Global-Health-Labs/NAATOS/readme.md

# NAATOS Documentation Website

Please visit <https://global-health-labs.github.io/NAATOS/> to learn about NAATOS and how to use this repository.
