Global-Health-Labs/NAATOS/docs/team.md

# Project Team

## Global Health Labs (GHL)

GHL is the lead developer of NAATOS, having invested in several areas of early stage research related to new tools and technologies for diagnosis of tuberculosis (and other endemic infectious diseases) in low-resource settings.

### Research and Development

- Luis Alonzo [:material-linkedin:](https://www.linkedin.com/in/luisalonzo/){:target="_blank"}
- Lex Ball [:material-linkedin:](https://www.linkedin.com/in/lex-ball-a0041219/){:target="_blank"}
- [Josh Bishop](https://github.com/jdbishop) [:material-linkedin:](https://www.linkedin.com/in/josh-bishop-ph-d-6207324/){:target="_blank"}
- Rose Buchmann [:material-linkedin:](https://www.linkedin.com/in/rosebuchmann/){:target="_blank"}
- [Stephen Burkot](https://github.com/sburkot24) [:material-linkedin:](https://www.linkedin.com/in/stephenburkot/){:target="_blank"}
- [Ryan Calderon](https://github.com/rcalderon04) [:material-linkedin:](https://www.linkedin.com/in/ryan-calderon-a6a02625/){:target="_blank"}
- Jason Cantera [:material-linkedin:](https://www.linkedin.com/in/jason-cantera-87554319/){:target="_blank"}
- John Connelly [:material-linkedin:](https://www.linkedin.com/in/john-connelly-22849122/){:target="_blank"}
- [Mike Deeds](https://deedstech.com/)
- Ming Dong [:material-linkedin:](https://www.linkedin.com/in/ming-dong-mba/){:target="_blank"}
- Ryan Gallagher [:material-linkedin:](https://www.linkedin.com/in/ryan-gallagher-308a41227/){:target="_blank"}
- Spencer Garing [:material-linkedin:](https://www.linkedin.com/in/spencer-garing-40a57796/){:target="_blank"}
- [Simon Ghionea](https://github.com/sghionea) [:material-linkedin:](https://www.linkedin.com/in/simonghionea/){:target="_blank"}
- Ben Grant [:material-linkedin:](https://www.linkedin.com/in/benjamin-grant-4a9a4222/){:target="_blank"}
- [Chin Ng Hei](https://github.com/ngchei) [:material-linkedin:](https://www.linkedin.com/in/chin-ng-ph-d-21522013/){:target="_blank"}
- Lance Jacobe [:material-linkedin:](https://www.linkedin.com/in/lancejacobemicro/){:target="_blank"}
- Jordyn Janshen [:material-linkedin:](https://www.linkedin.com/in/jordyn-janshen-/){:target="_blank"}
- [Matt Keller](https://github.com/mkeller99) [:material-linkedin:](https://www.linkedin.com/in/matt-keller-a360b483/){:target="_blank"}
- Khushboo Khimani [:material-linkedin:](https://www.linkedin.com/in/khushboo-khimani/){:target="_blank"}
- Remy Kooistra [:material-linkedin:](https://www.linkedin.com/in/remy-kooistra-0970a5114/){:target="_blank"}
- Anne-Laure Le Ny [:material-linkedin:](https://www.linkedin.com/in/anne-laure-le-ny-a7377a3/){:target="_blank"}
- [Andrew Miller](https://github.com/andrewmiller-ghl) [:material-linkedin:](https://www.linkedin.com/in/andrew-miller-78938520/){:target="_blank"}
- Eric Nalefski [:material-linkedin:](https://www.linkedin.com/in/eric-nalefski-0b942714/){:target="_blank"}
- Bryan Norton [:material-linkedin:](https://www.linkedin.com/in/bryanjnorton/){:target="_blank"}
- Julie Pendergraft [:material-linkedin:](https://www.linkedin.com/in/julielpendergraft/){:target="_blank"}
- Jamie Purcell [:material-linkedin:](https://www.linkedin.com/in/jamie-purcell-phd-098aa65a/){:target="_blank"}
- Rafael Rivera [:material-linkedin:](https://www.linkedin.com/in/rafael-rivera-437553124/){:target="_blank"}
- Anjali Sehrawat [:material-linkedin:](https://www.linkedin.com/in/anjalisehrawat/){:target="_blank"}
- Ethan Spencer [:material-linkedin:](https://www.linkedin.com/in/ethanrspencer/){:target="_blank"}
- Amy Steadman [:material-linkedin:](https://www.linkedin.com/in/amy-steadman-aa80578b/){:target="_blank"}
- Ben Sullivan [:material-linkedin:](https://www.linkedin.com/in/benpsullivan/){:target="_blank"}
- Wenbo Wang [:material-linkedin:](https://www.linkedin.com/in/wenbowang1pe/){:target="_blank"}
- Xiaohong Zhang [:material-linkedin:](https://www.linkedin.com/in/xiaohong-zhang22111/){:target="_blank"}

### Product Management

- Isabel Izek [:material-linkedin:](https://www.linkedin.com/in/isabel-izek/){:target="_blank"}

### Program Management

- Nikki Sanchez Comeau [:material-linkedin:](https://www.linkedin.com/in/nikkisanchezcomeau/){:target="_blank"}

### Clinical

- Julian Atim [:material-linkedin:](https://www.linkedin.com/in/jatim/){:target="_blank"}
- Christine Bachman [:material-linkedin:](https://www.linkedin.com/in/cmbachman/){:target="_blank"}

### Legal

- Davina Inslee [:material-linkedin:](https://www.linkedin.com/in/davina-childs-inslee-0268a93/){:target="_blank"}
- Kris Weafer [:material-linkedin:](https://www.linkedin.com/in/kristiest/){:target="_blank"}

### Quality

- Stacy Hyatt [:material-linkedin:](https://www.linkedin.com/in/stacy-hyatt/){:target="_blank"}
- Cheryl Taylor [:material-linkedin:](https://www.linkedin.com/in/cheryl-taylor-880a48/){:target="_blank"}

### Program Strategy

- Sharon Bergquist [:material-linkedin:](https://www.linkedin.com/in/sharonbergquist/){:target="_blank"}
- Carlos Gonzalez [:material-linkedin:](https://www.linkedin.com/in/cbgonz%C3%A1lezphd/){:target="_blank"}
- Rob Jenison [:material-linkedin:](https://www.linkedin.com/in/rob-jenison-9540018/){:target="_blank"}
- Steve Kern [:material-linkedin:](https://www.linkedin.com/in/se-kern/){:target="_blank"}
- Bernhard Weigl [:material-linkedin:](https://www.linkedin.com/in/bernhard-h-weigl/){:target="_blank"}

## Collaborators

### ACT-IVD

ACT-IVD is the Regulatory consultant for NAATOS.

- Robyn Meurant [:material-linkedin:](https://www.linkedin.com/in/robyn-meurant-act-ivd/){:target="_blank"}

### [Central Centerless Grinding (CCG)](http://ccgonline.net/){:target="_blank"} / [Scitus Engineering](http://scitusengineering.com/){:target="_blank"}

[CCG](http://ccgonline.net/){:target="_blank"} is the Hardware Design and Instrument Manufacturing partner for the NAATOS TB V1 modules.

- Philip Almquist
- Mark Flanagan[^CCG]
- James Paolino[^CCG]
- Ed Sienczylo
- David Sorenson
- Binh Tran

### [Diagnostics Consulting Network (DCN)](https://dcndx.com/){:target="_blank"}

[DCN Dx](https://dcndx.com/){:target="_blank"} is the Development, Kit Production, and Technology Transfer partner for NAATOS.

### [Global Access Diagnostics (GADx)](https://www.globalaccessdx.com/){:target="_blank"}

[GADx](https://www.globalaccessdx.com/){:target="_blank"} is the Research and Development partner for NAATOS.

- Lucy Beales
- Mike Best
- Sarah Chapman
- Paul Davis
- Michael Johnson
- Gabriela Kocurova
- Kevin Land[^GADx]
- Gerhard Nebe-Von-Caron
- Katherine Rumary
- Peter Salkield
- Adrian Walker
- Xiaoxiang (Tom) Yan

### [Greaves Best Design](http://www.greavesbest.co.uk/){:target="_blank}

- Mike Best is the Product Design partner for NAATOS TB V1.

### [Health Innovation Advisors (HIA)](https://innovationadvisors.org/){:target="_blank"}

[HIA](https://innovationadvisors.org/){:target="_blank"} is the User Research and Implementation Science consultant for NAATOS.

- Melissa Mugambi[^HIA] [:material-linkedin:](https://www.linkedin.com/in/melissamugambi/){:target="_blank"}

### [Market Access Africa (MAA)](https://www.marketaccess.africa/){:target="_blank"}

[MAA](https://www.marketaccess.africa/){:target="_blank"} is the Market Research and Product Introduction consultant for NAATOS.

- Olawale Ajose[^MAA] [:material-linkedin:](https://www.linkedin.com/in/olawale-ajose-1521b975/){:target="_blank"}
- Obakeng Bagopi
- Zipporah Bundi
- Nancy Njoku-Attah
- Wambui Nyabero
- Pam Pillay[^MAA] [:material-linkedin:](https://www.linkedin.com/in/pam-pillay-a7b5ba65/){:target="_blank"}
- Newton Runyowa
- Chris Smit
- Shabnam Zavahir

### [MicroMed Solutions](https://www.micromedsolutions.com/){:target="_blank"}, a division of LasX Industries

[MicroMed Solutions](https://www.micromedsolutions.com/){:target="_blank"} is the Converting vendor for NAATOS.

- Jon Craven[^MicroMed]
- Rye Mecum
- Derek Spencer
- Hanh Tran

### [Odic](https://odic.com/){:target="_blank"}

[Odic](https://odic.com/){:target="_blank"} is the Electronics Design partner for the NAATOS TB V1 modules.

- Rob Filipkowski[^Odic]
- Liam Sullivan
- Ian O’Neil
- Dylan Derose

### [Vantage MedTech](https://vantagemedtech.com/){:target="_blank"}

[Vantage](https://vantagemedtech.com/){:target="_blank"} is the Industrial Design vendor for NAATOS V2.

- Steven Madsen
- Thomas Van Dyk

[^CCG]: Corresponding team members for CCG.
[^GADx]: Corresponding team member for GADx.
[^HIA]: Corresponding team member for HIA.
[^MAA]: Corresponding team members for MAA.
[^MicroMed]: Corresponding team member for MicroMed Solutions.
[^Odic]: Corresponding team member for Odic.
