Global-Health-Labs/NAATOS/docs/index.md

# NAATOS Project Overview

## The Diagnostics Gap in Primary Health Care

Health systems based on primary health care (PHC) have better population health, health equity, health care quality, and lower health expenditure.[^1] However, access to accurate and affordable diagnostics remains the weakest link in primary care worldwide.[^2] Without accurate and timely diagnosis many people with treatable diseases (e.g., TB, HIV/AIDS, malaria, pneumonia, hepatitis C, etc.) go undetected, impacting health and economic outcomes for much of the world's population.

Low- and middle-income countries (LMICs) in particular need scalable and regionally produced diagnostic solutions to ensure inclusive and equitable responses to global health threats and local health needs. International resolutions, like the World Health Assembly Resolution 76.5,[^3] and initiatives, like the Africa Collaborative Initiative to Advance Diagnostics (AFCAD),[^4] aim to strengthen diagnostic capacity, promote local manufacturing, and harmonize regulatory processes, particularly in low-income countries[^5]. But to realize these targets globally, a sustainable and resilient ecosystem of regional research and product development must exist in LMICs to ensure health priorities are met locally.[^6] This approach is essential to build resilience in healthcare systems and to foster a responsive and self-sufficient local industry capable of addressing global health threats.

[Global Health Labs (GHL)](https://gatesopenresearch.org/gateways/ghlabs/about-this-gateway){:target="_blank"} was a non-profit organization that from 2020 to 2025 created and de-risked innovative health technologies with the ultimate goal of enabling manufacturing and commercialization partners to make them available at the point of need. One product of GHL is NAATOS, Nucleic Acid Amplification Test On a Strip. NAATOS is a novel diagnostic platform conceived at GHL that integrates Nucleic Acid Amplification Test (NAAT) and Lateral Flow Assay (LFA) technologies to empower primary health care and diagnostic ecosystems with tests that are sensitive, specific, affordable, easy-to-use, and available.

NAATs are the gold standard for sensitivity and specificity in diagnostics, but their success depends on expensive lab infrastructure (e.g., reliable power, environmental controls, equipment maintenance) that is cost-prohibitive for PHC settings, most of which have only basic lab capabilities. LFAs bridge this gap by offering a low-cost and easy-to-use alternative that can be locally produced and readily deployed at the point of care in PHC, but LFAs lack the sensitivity and specificity of NAATs. NAATOS is a blueprint for obtaining the best characteristics of these technologies without their drawbacks.

## [NAATOS TB V1](./TB-V1/overview.md)

The United Nations Sustainable Development Goal 3.3 targets an end to the global tuberculosis epidemic by 2030.[^7] Unfortunately, poor diagnostic access and low utilization of TB testing has allowed large-scale treatment delays and disease transmission. However, these issues can be addressed with an accurate, affordable, and accessible diagnostic tool that meets the performance criteria of high sensitivity, specificity (95% specificity), and affordability ($4.5 USD all-inclusive) set out by the WHO.[^8]

The first demonstrated application of NAATOS is as an aid in diagnosis for tuberculosis (TB) in individuals 15 years of age and older with signs and symptoms of pulmonary TB. This version of NAATOS, TB V1, is a modular, instrumented-but-portable diagnostic system that returns genetic confirmation of *Mycobacterium tuberculosis* in a dorsal tongue swab specimen and accommodates variable patient volumes in near-point-of-care settings.

## [NAATOS V2](./V2/overview.md)

The next generation of NAATOS is a fully disposable, non-instrumented diagnostic platform. This version of NAATOS, V2, combines the core consumable technology of NAATOS TB V1 with a disposable power and control component that replaces the modular instrumentation of NAATOS TB V1. NAATOS V2 is intended as a blueprint for tests without difficult sample preparation requirements in true point-of-care settings. As an example, the design for a multiplexed HPV test is provided.

## The Future of NAATOS

The goal of this documentation is to dedicate the NAATOS TB V1 and NAATOS V2 technology to the public domain as a global good, in the hopes that it informs the creation of new and needed diagnostic tools that are accurate, affordable, and accessible.

[^1]: Stange KC, Miller WL, Etz RS (2023). [The Role of Primary Care in Improving Population Health](https://doi.org/10.1111/1468-0009.12638){:target="_blank"}. Milbank Quarterly, 101:795-840.
[^2]: Think Global Health (accessed Oct 2025). [Diagnostic Gaps in Global Health](https://www.thinkglobalhealth.org/article/diagnostic-gaps-global-health){:target="_blank"}.
[^3]: World Health Assembly (accessed Oct 2025). [Strengthening diagnostics capacity](https://www.who.int/activities/strengthening-diagnostics-capacity){:target="_blank"}. [PDF](https://apps.who.int/gb/ebwha/pdf_files/WHA76/A76_R5-en.pdf).
[^4]: Africa CDC (accessed Oct 2025). [Africa Collaborative Initiative to Advance Diagnostics](https://africacdc.org/programme/laboratory-systems-and-networks/africa-collaborative-initiative-to-advance-diagnostics/){:target="_blank"}.
[^5]: Yimer SA, Booij BB, Tobert G, Hebbeler A, Oloo P, Brangel P, et al. (2024). [Rapid diagnostic test: a critical need for outbreak preparedness and response for high priority pathogens](https://doi.org/10.1136/bmjgh-2023-014386){:target="_blank"}. BMJ Global Health, 9:e014386.
[^6]: FIND and Unitaid (13-14 Apr 2023). [Building for sustainability: accelerating regional manufacturing for diagnostics](https://unitaid.org/publication/report-building-for-sustainability-accelerating-regional-manufacturing-for-diagnostics-find-and-unitaid/){:target="_blank"}. [PDF](https://www.finddx.org/wp-content/uploads/2024/01/20230413_rep_accelerating_rm_for_dx_FV_EN.pdf){:target="_blank"}.
[^7]: WHO (accessed 2025). [Incidence of tuberculosis (per 100 000 population per year)](https://data.who.int/indicators/i/13B4226/C288D13){:target="_blank"}.
[^8]: Brümmer LE, Thompson RR, Malhotra A, Shrestha S, Kendall EA, Andrews JR, Phillips P, Nahid P, Cattamanchi A, Marx FM, Denkinger CM, Dowdy DW (25 Jan 2024). [Cost-effectiveness of Low-complexity Screening Tests in Community-based Case-finding for Tuberculosis](https://doi.org/10.1093/cid/ciad501){:target="_blank"}. Clin Infect Dis. 78(1):154-163.
