Global-Health-Labs/NAATOS/docs/TB-V1/technical.md

# Technical

## Design Review

## Technical Reviews

### Stage Gate 1

### Stage Gate 2

### Stage Gate 3

### Stage Gate 4
