Global-Health-Labs/NAATOS/docs/img/NAATOS-TB-V1-system-diagram.png

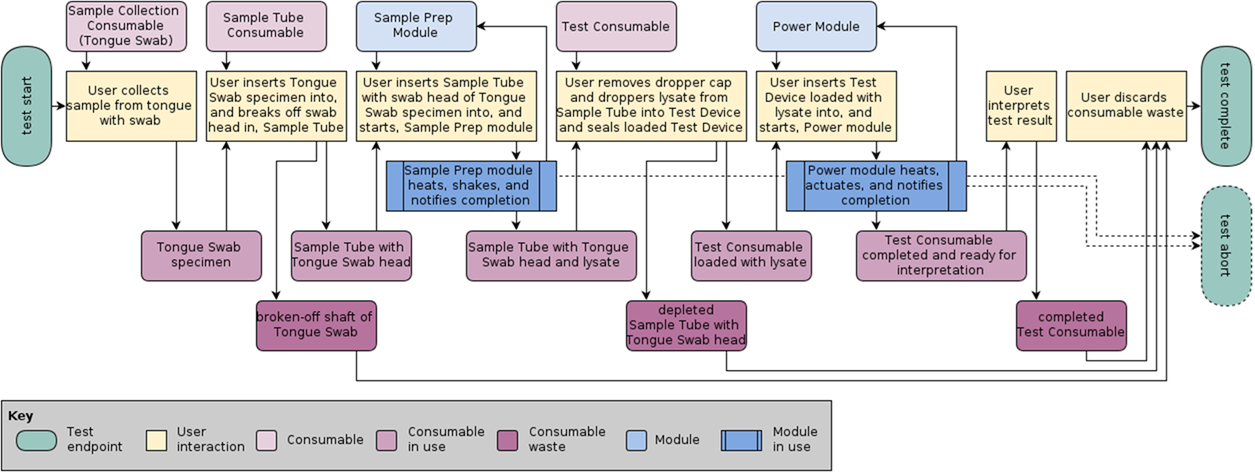
docs/img/NAATOS-TB-V1-system-diagram.png
