Global-Health-Labs/NAATOS/docs/img/NAATOS-V0-iso.png

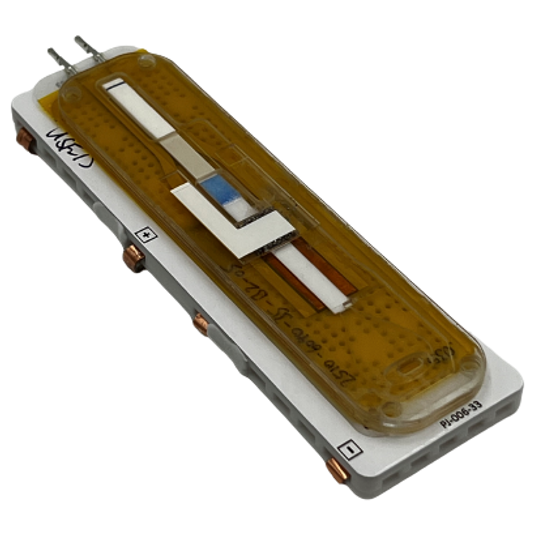
docs/img/NAATOS-V0-iso.png
