Global-Health-Labs/NAATOS/docs/V2/MK8C/CAD/0016-001-00.SLDASM

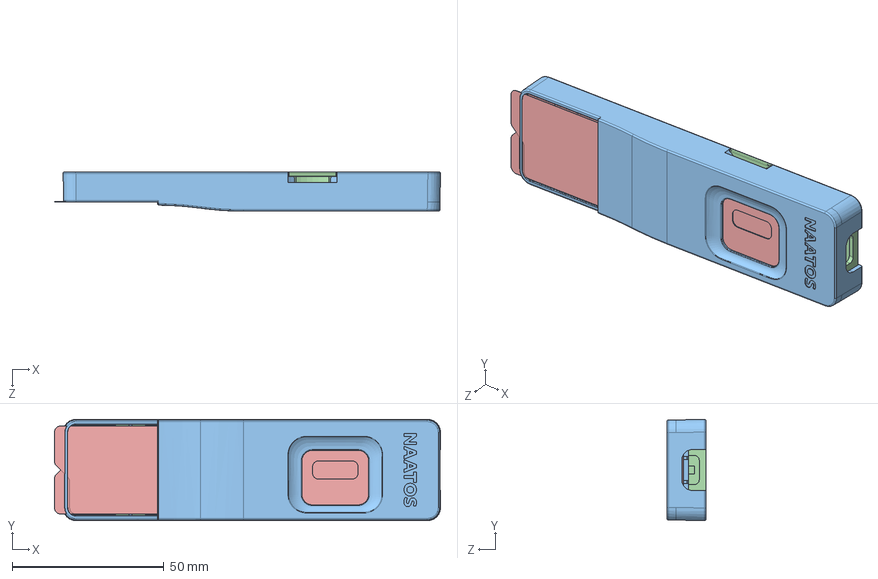
[picture p107: CAD file, 2025-10-29]
docs/V2/MK8C/CAD/0016-001-00.SLDASM
127.2 x 33.3 x 13.0 mm
