Global-Health-Labs/NAATOS/docs/V2/MK6/CAD/Plastic Laminate Housing 1088.SLDASM

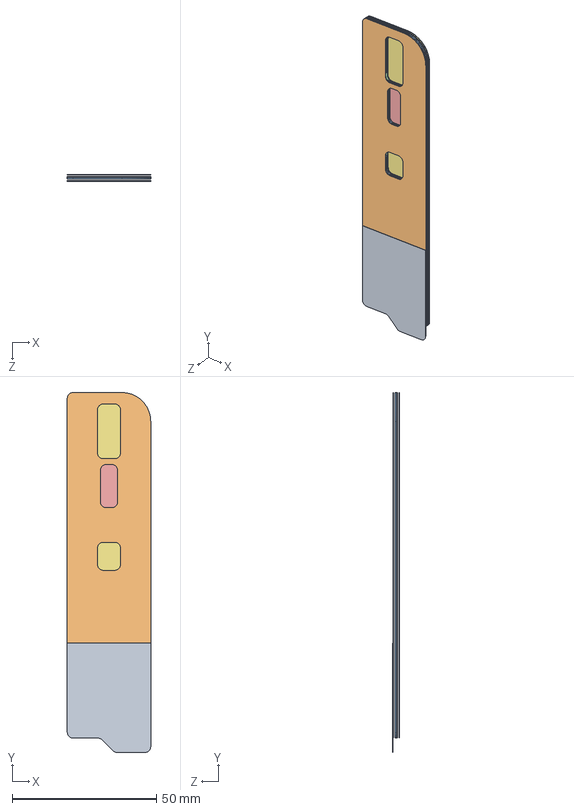
[picture p108: CAD file, 2025-10-24]
docs/V2/MK6/CAD/Plastic Laminate Housing 1088.SLDASM
29.0 x 125.0 x 2.39 mm
Base Layer 1088
Lyo Spacer Adhesive Layer 1088
Lyo Spacer Layer 1088
Vent Spacer Adhesive Layer 1088
Vent Spacer Layer 1088
User Interface Adhesive Layer 1088
User Interface Liner 1088
