Global-Health-Labs/NAATOS/docs/V2/MK6/CAD/0078-001-00.SLDASM

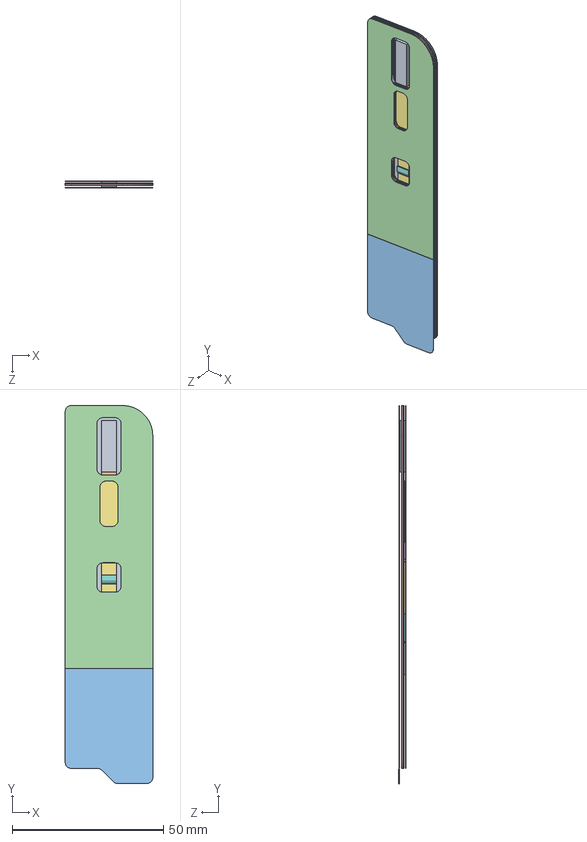
[picture p109: CAD file, 2025-10-24]
docs/V2/MK6/CAD/0078-001-00.SLDASM
29.0 x 125.0 x 2.39 mm
Base Layer 1088
Lyo Spacer Adhesive Layer 1088
Lyo Spacer Layer 1088
Vent Spacer Adhesive Layer 1088
Vent Spacer Layer 1088
User Interface Adhesive Layer 1088
User Interface Liner 1088
Backing Card 1088
Sample Pad 1088
Amplification Pad 1088
Valve Pad 1088
Conjugate Pad 1088
Analytical Pad 1088
Test Line 1088
Internal Amplification Control Line 1088
Flow Control Line 1088
Waste Pad 1088
