Global-Health-Labs/NAATOS/docs/V2/MK6/CAD/LFA Laminate Strip 1088.SLDASM

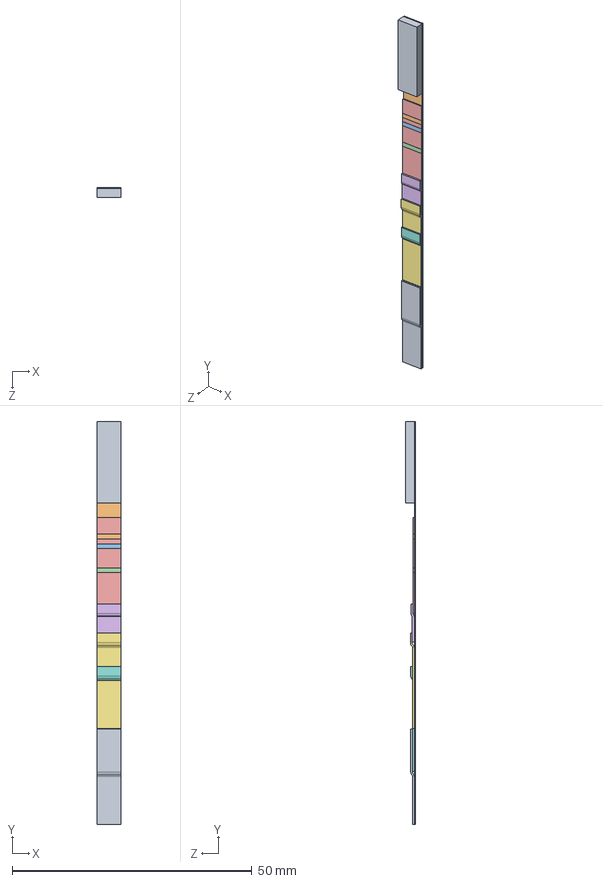
[picture p110: CAD file, 2025-10-24]
docs/V2/MK6/CAD/LFA Laminate Strip 1088.SLDASM
5.00 x 84.0 x 2.07 mm
Backing Card 1088
Sample Pad 1088
Amplification Pad 1088
Valve Pad 1088
Conjugate Pad 1088
Analytical Pad 1088
Test Line 1088
Internal Amplification Control Line 1088
Flow Control Line 1088
Waste Pad 1088
