Global-Health-Labs/NAATOS/docs/V2/MK6/CAD/Analytical Pad w Lines 1088.SLDASM

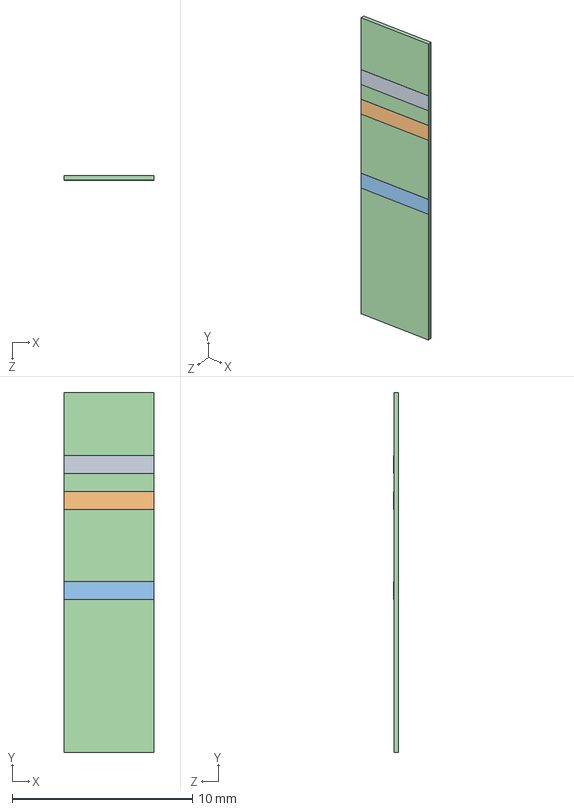
[picture p111: CAD file, 2025-10-24]
docs/V2/MK6/CAD/Analytical Pad w Lines 1088.SLDASM
5.00 x 20.0 x 0.265 mm
Analytical Pad 1088
Test Line 1088
Internal Amplification Control Line 1088
Flow Control Line 1088
