Global-Health-Labs/NAATOS/docs/V2/MK6/CAD/0008-007-00.SLDPRT

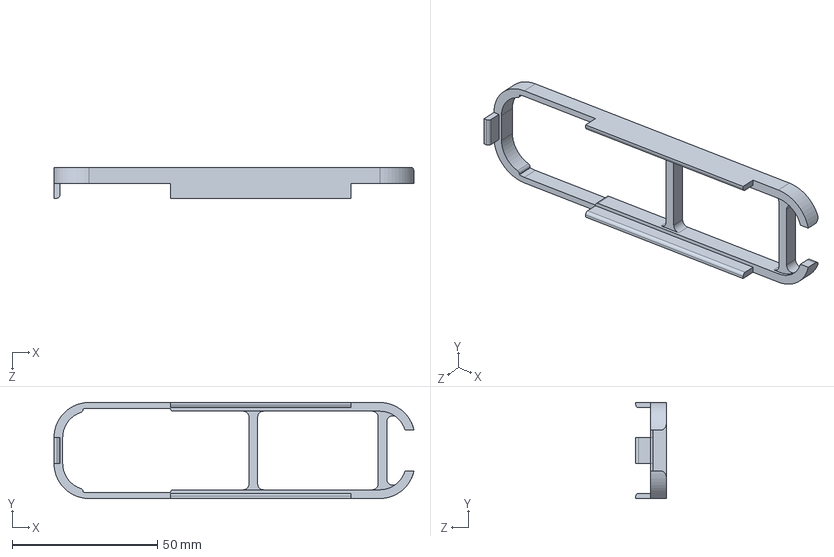
[picture p112: CAD file, 2025-10-24]
docs/V2/MK6/CAD/0008-007-00.SLDPRT
123.7 x 33.0 x 10.5 mm
