Global-Health-Labs/NAATOS/docs/V2/MK8AA/CAD/0017-006-00.SLDPRT

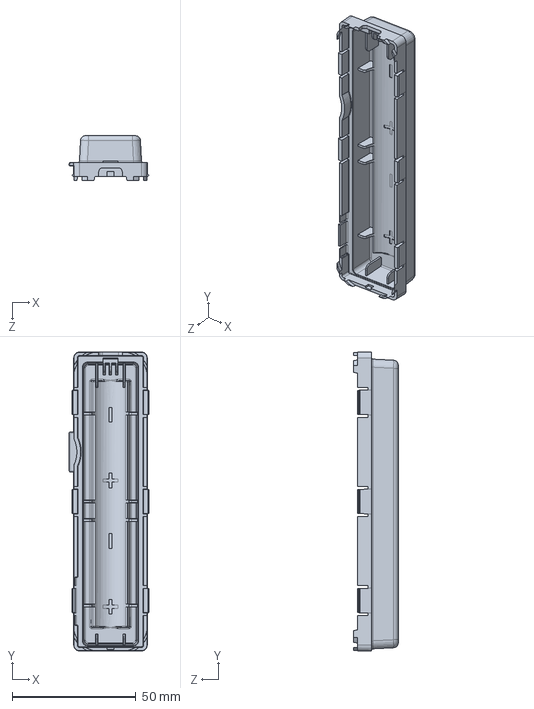
[picture p113: CAD file, 2025-10-29]
docs/V2/MK8AA/CAD/0017-006-00.SLDPRT
32.1 x 120.7 x 18.0 mm
