Global-Health-Labs/NAATOS/docs/V2/MK8C/CAD/0016-005-00.SLDPRT

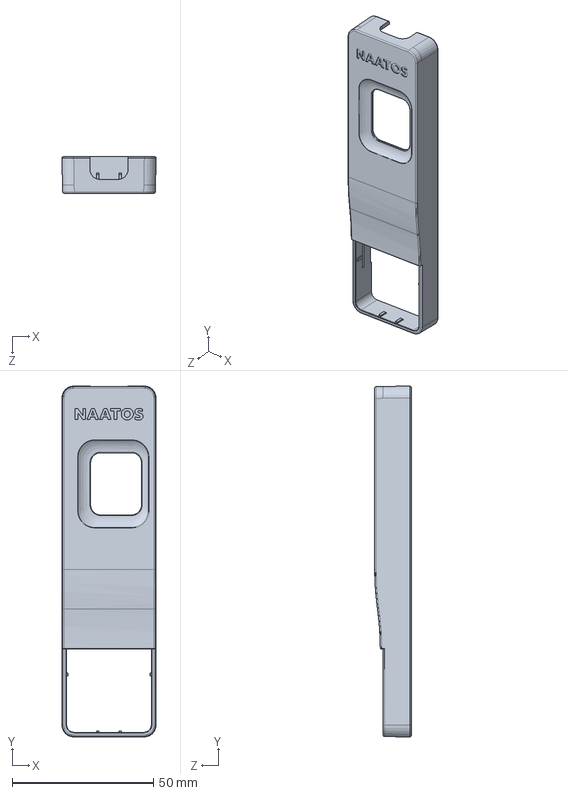
[picture p114: CAD file, 2025-10-29]
docs/V2/MK8C/CAD/0016-005-00.SLDPRT
33.3 x 124.3 x 13.0 mm
