Global-Health-Labs/NAATOS/docs/V2/MK8C/Derived/0016-006-00.STL

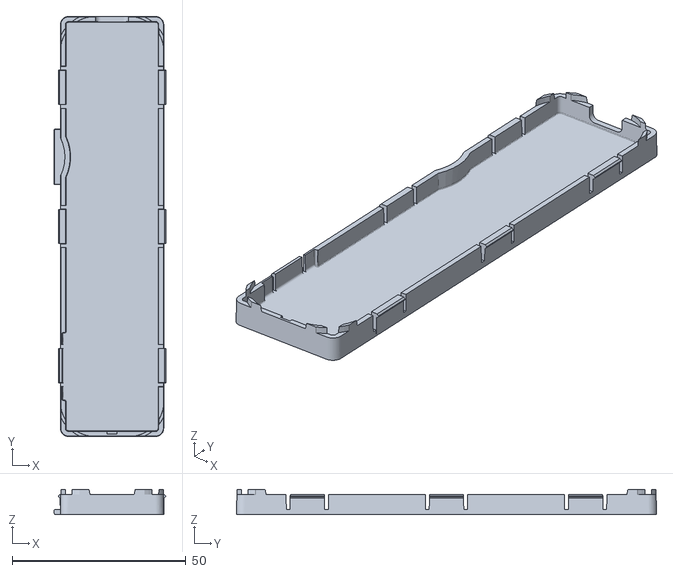
[picture p115: CAD file, 2025-10-29]
docs/V2/MK8C/Derived/0016-006-00.STL
32.1 x 120.7 x 7.29
