Global-Health-Labs/NAATOS/docs/V2/MK6/CAD/0008-009-00.SLDPRT

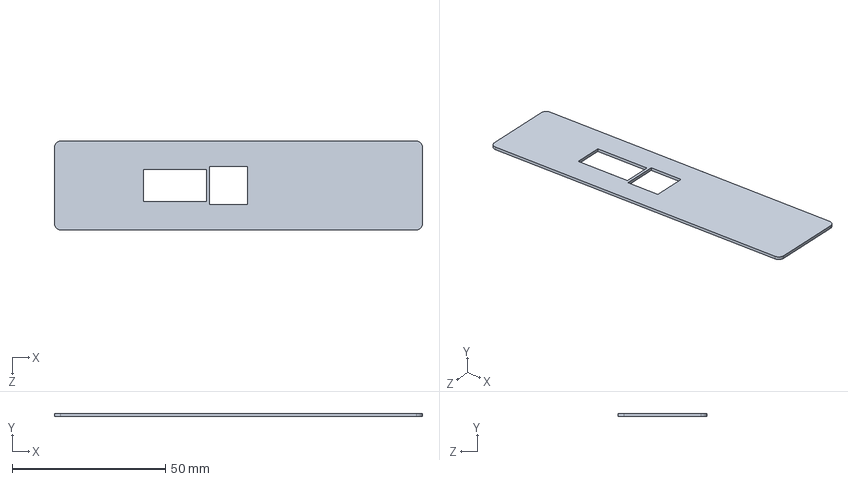
[picture p116: CAD file, 2025-10-24]
docs/V2/MK6/CAD/0008-009-00.SLDPRT
120.0 x 1.00 x 29.0 mm
