Global-Health-Labs/NAATOS/docs/V2/MK6/Derived/0008-003-00.STL

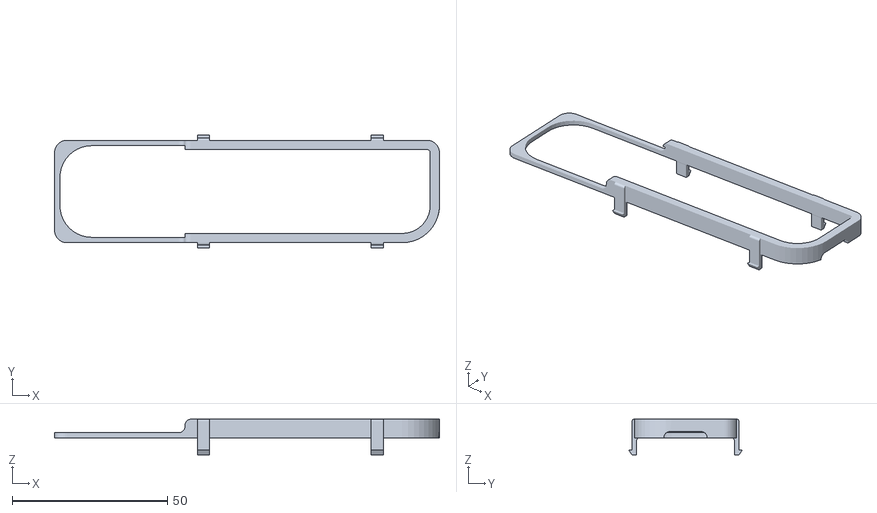
[picture p117: CAD file, 2025-10-29]
docs/V2/MK6/Derived/0008-003-00.STL
124.0 x 36.5 x 11.5
