Global-Health-Labs/NAATOS/docs/V2/MK8AA/CAD/AA LR6 1.5V.SLDPRT

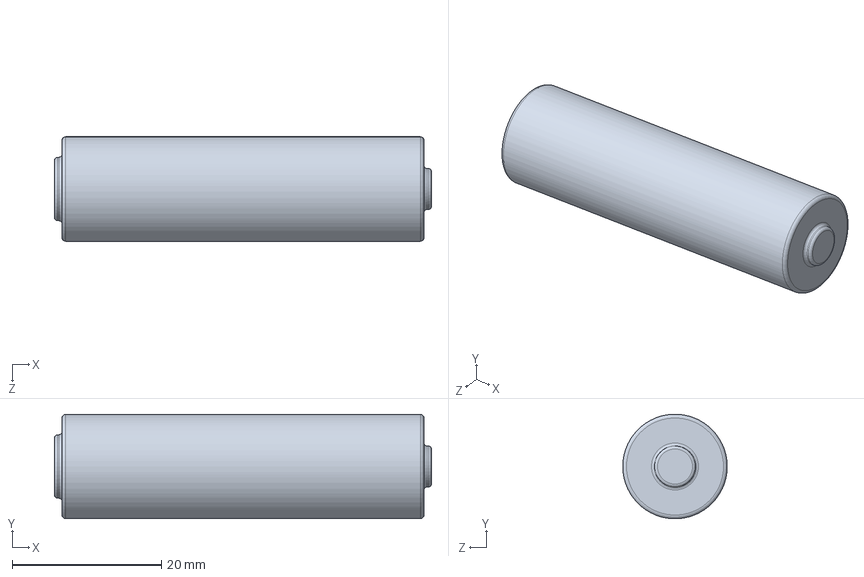
[picture p118: CAD file, 2025-10-29]
docs/V2/MK8AA/CAD/AA LR6 1.5V.SLDPRT
50.5 x 14.0 x 14.0 mm
