Global-Health-Labs/NAATOS/docs/V2/MK8AA/Derived/0017-005-00.STL

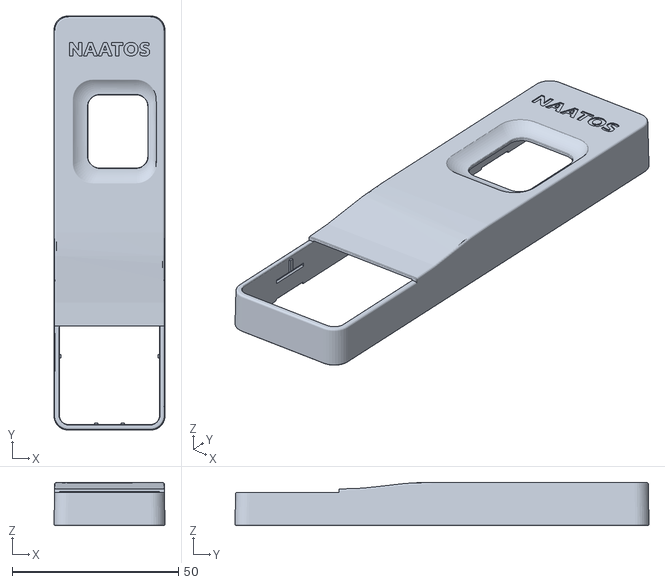
[picture p119: CAD file, 2025-10-29]
docs/V2/MK8AA/Derived/0017-005-00.STL
33.3 x 124.3 x 13.0
