Global-Health-Labs/NAATOS/docs/V2/MK8C/CAD/0017-004-00.SLDPRT

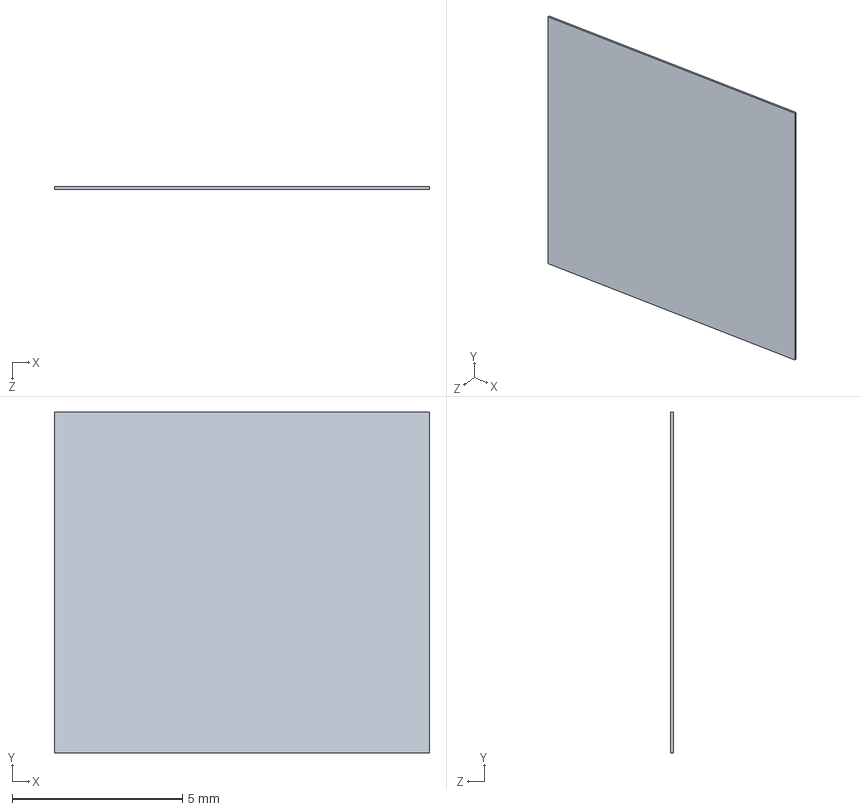
[picture p120: CAD file, 2025-10-29]
docs/V2/MK8C/CAD/0017-004-00.SLDPRT
11.0 x 10.0 x 0.0737 mm
