Global-Health-Labs/NAATOS/docs/V2/MK8AA/CAD/0078-005-00.SLDPRT

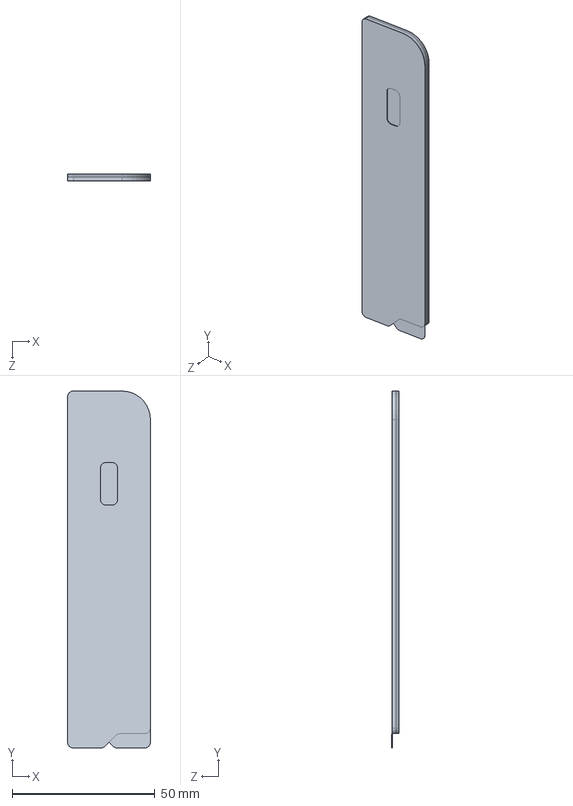
[picture p122: CAD file, 2025-10-29]
docs/V2/MK8AA/CAD/0078-005-00.SLDPRT
29.0 x 125.0 x 2.58 mm
