Global-Health-Labs/NAATOS/docs/V2/MK8AA/Derived/0017-008-00.STL

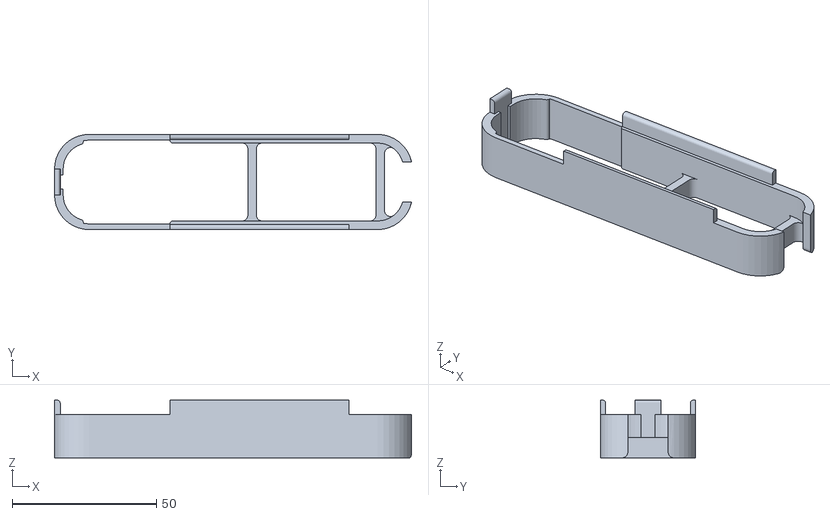
[picture p123: CAD file, 2025-10-29]
docs/V2/MK8AA/Derived/0017-008-00.STL
123.7 x 33.0 x 20.0
