Global-Health-Labs/NAATOS/docs/V2/MK6/CAD/Internal Amplification Control Line 1088.SLDPRT

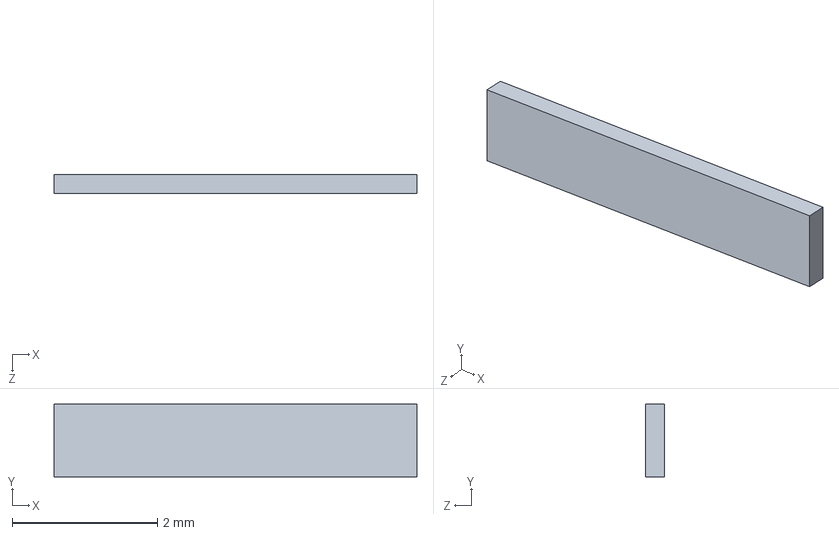
[picture p124: CAD file, 2025-10-24]
docs/V2/MK6/CAD/Internal Amplification Control Line 1088.SLDPRT
5.00 x 1.00 x 0.265 mm
