Global-Health-Labs/NAATOS/docs/V2/MK6/Derived/0008-004-00.STL

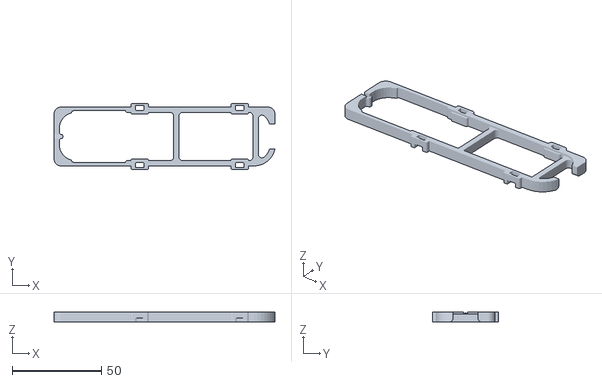
[picture p125: CAD file, 2025-10-29]
docs/V2/MK6/Derived/0008-004-00.STL
123.7 x 37.0 x 5.50
