Global-Health-Labs/NAATOS/docs/V2/MK8AA/CAD/119.SLDPRT

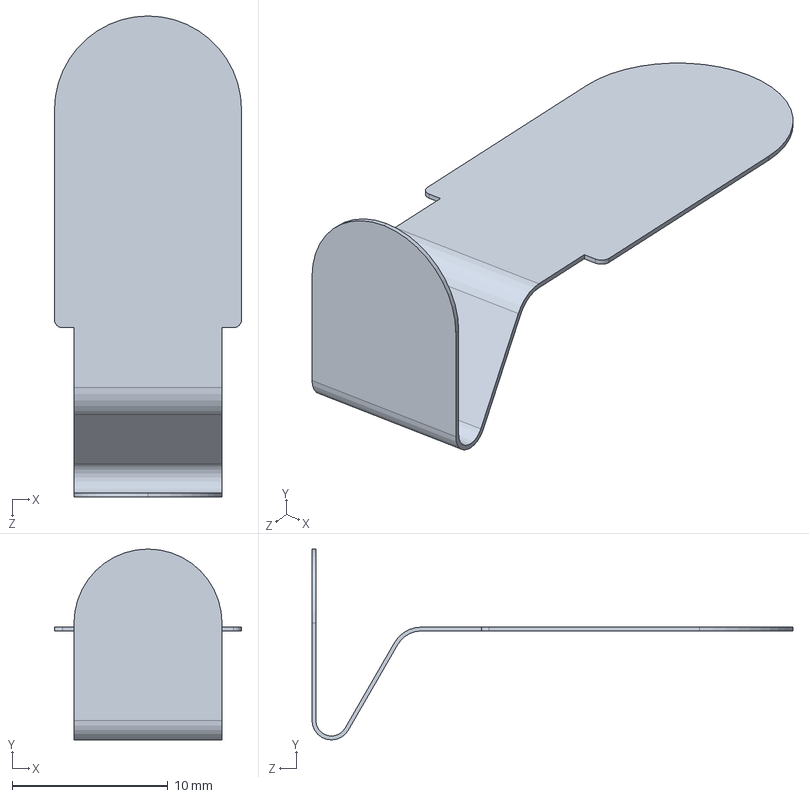
[picture p126: CAD file, 2025-10-29]
docs/V2/MK8AA/CAD/119.SLDPRT
12.0 x 12.2 x 30.9 mm
