Global-Health-Labs/NAATOS/docs/V2/MK8AA/Derived/0017-007-00.STL

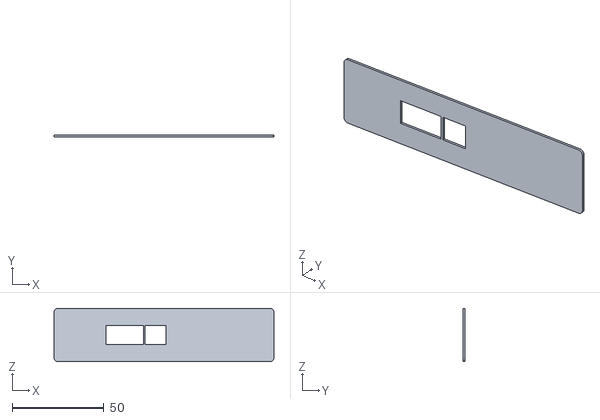
[picture p127: CAD file, 2025-10-29]
docs/V2/MK8AA/Derived/0017-007-00.STL
120.0 x 1.00 x 29.0
