Global-Health-Labs/NAATOS/docs/V2/MK6/CAD/Heater zones.SLDPRT

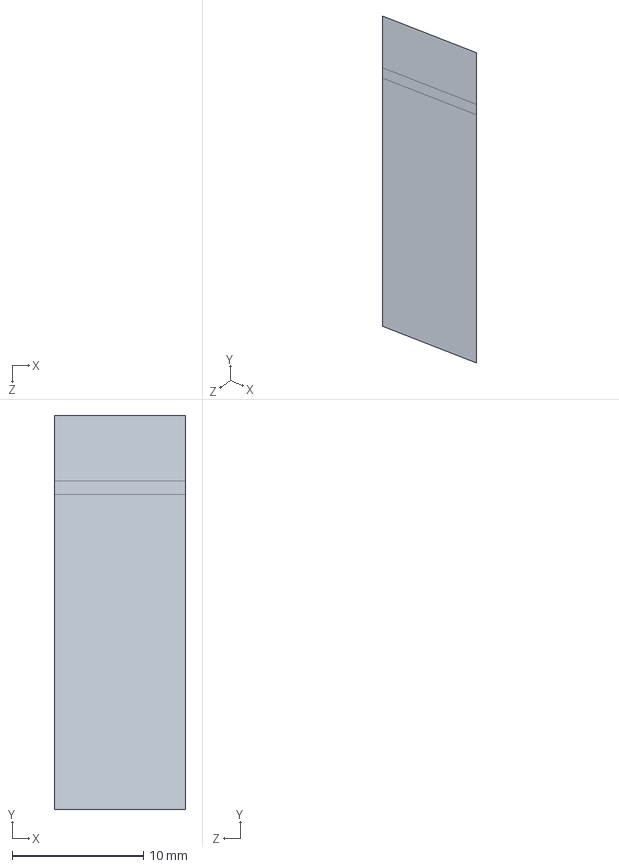
[picture p128: CAD file, 2025-10-24]
docs/V2/MK6/CAD/Heater zones.SLDPRT
10.0 x 30.0 x 0 mm
