Global-Health-Labs/NAATOS/docs/V2/MK8C/CAD/0017-003-00.SLDPRT

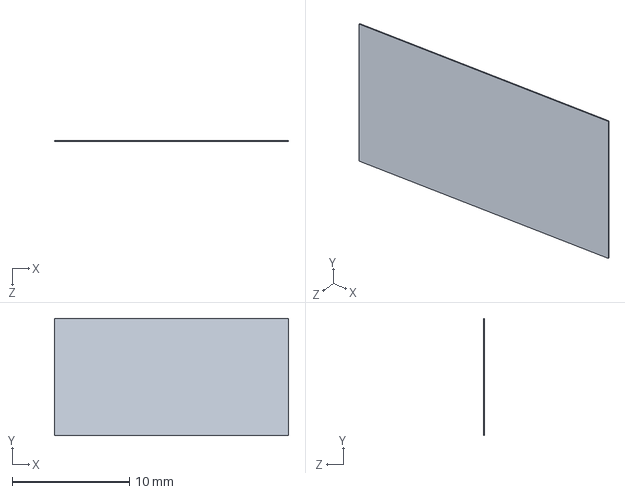
[picture p129: CAD file, 2025-10-29]
docs/V2/MK8C/CAD/0017-003-00.SLDPRT
20.0 x 10.0 x 0.0737 mm
