Global-Health-Labs/NAATOS/docs/V2/MK6/CAD/0008-008-00.SLDPRT

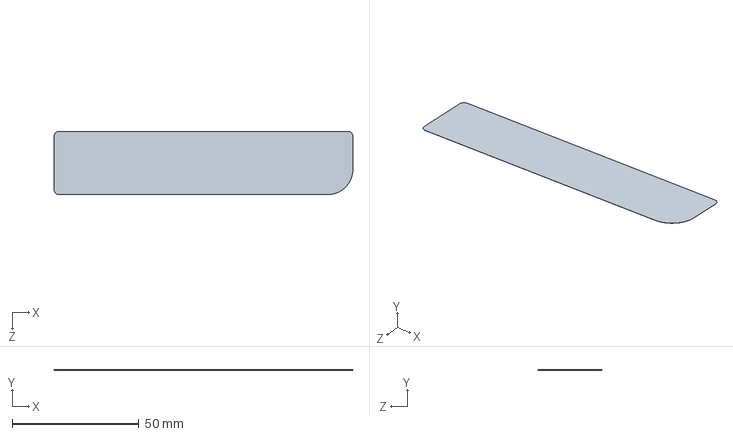
[picture p130: CAD file, 2025-10-24]
docs/V2/MK6/CAD/0008-008-00.SLDPRT
118.0 x 0.05 x 25.0 mm
