Global-Health-Labs/NAATOS/docs/V2/MK6/CAD/Conjugate Pad 1088.SLDPRT

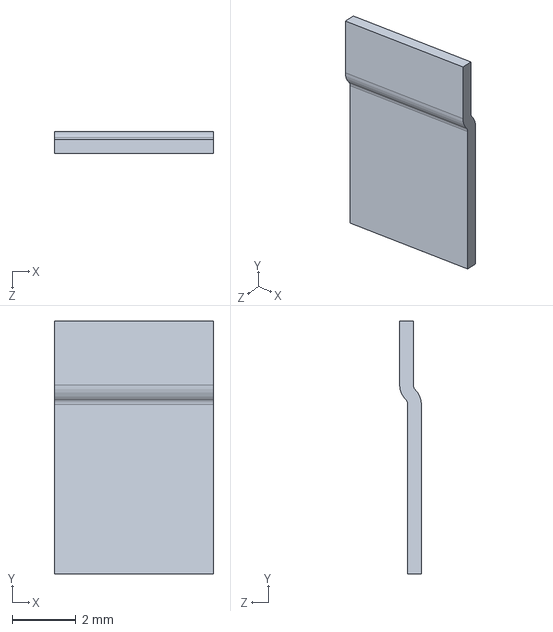
[picture p131: CAD file, 2025-10-24]
docs/V2/MK6/CAD/Conjugate Pad 1088.SLDPRT
5.00 x 7.93 x 0.685 mm
