Global-Health-Labs/NAATOS/docs/V2/MK6/CAD/User Interface Layer.SLDPRT

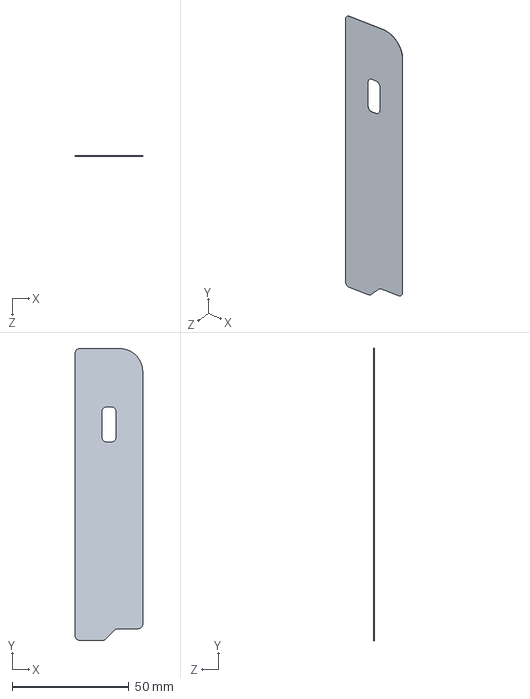
[picture p132: CAD file, 2025-10-24]
docs/V2/MK6/CAD/User Interface Layer.SLDPRT
29.0 x 125.0 x 0.125 mm
