Global-Health-Labs/NAATOS/docs/V2/MK6/CAD/User Interface Liner 1088.SLDPRT

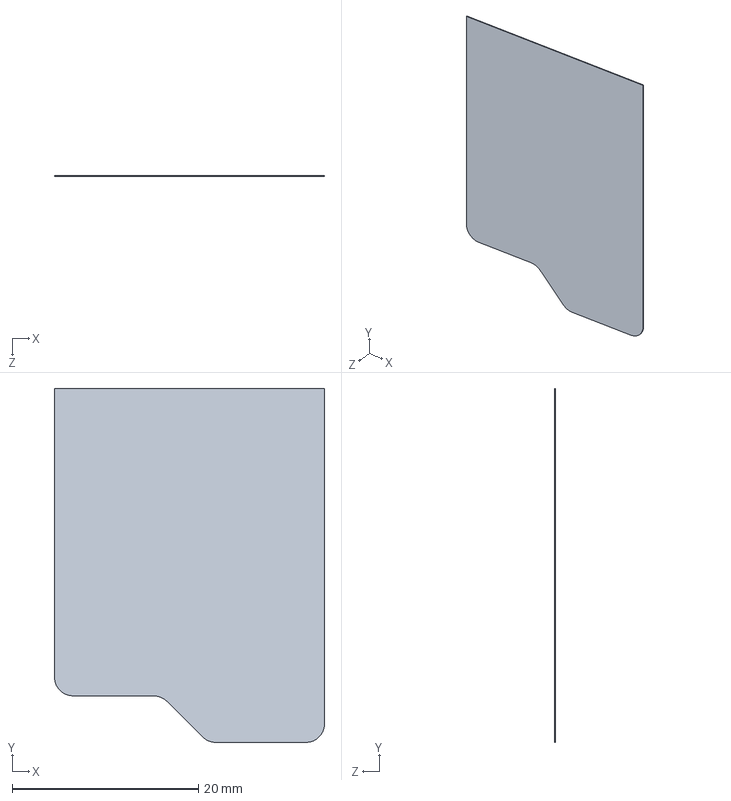
[picture p133: CAD file, 2025-10-24]
docs/V2/MK6/CAD/User Interface Liner 1088.SLDPRT
29.0 x 38.0 x 0.11 mm
