Global-Health-Labs/NAATOS/docs/V2/MK6/CAD/Valve Pad 1088.SLDPRT

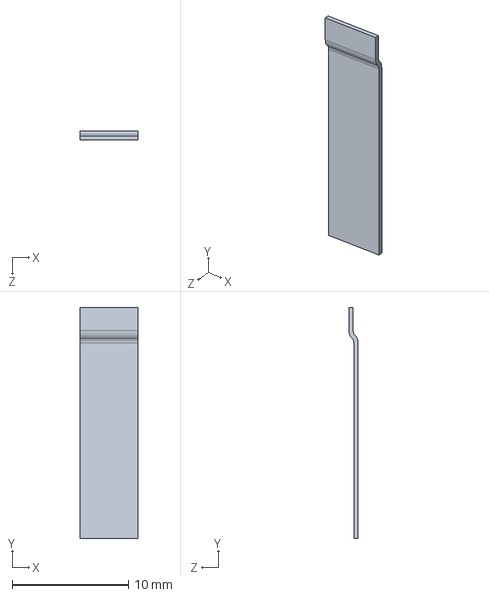
[picture p136: CAD file, 2025-10-24]
docs/V2/MK6/CAD/Valve Pad 1088.SLDPRT
5.00 x 19.9 x 0.8 mm
