Global-Health-Labs/NAATOS/docs/V2/MK6/CAD/Analytical Pad 1088.SLDPRT

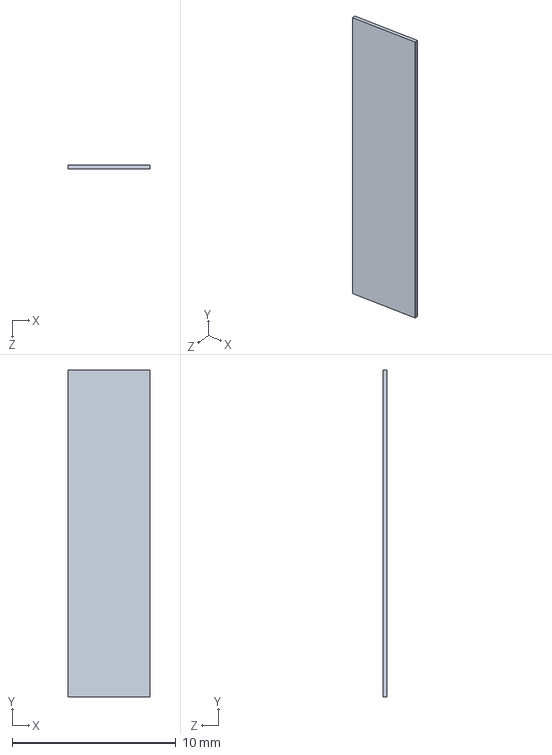
[picture p138: CAD file, 2025-10-24]
docs/V2/MK6/CAD/Analytical Pad 1088.SLDPRT
5.00 x 20.0 x 0.255 mm
