Global-Health-Labs/NAATOS/docs/V2/MK6/CAD/Amplification Pad 1088.SLDPRT

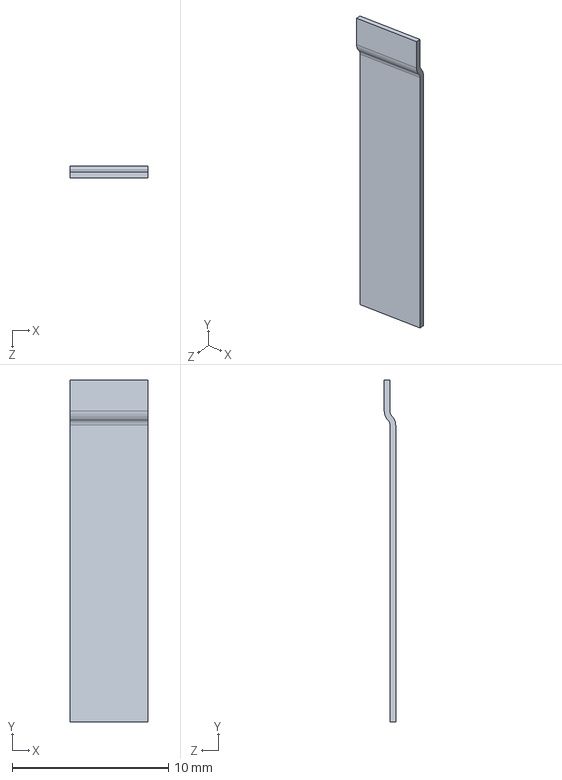
[picture p139: CAD file, 2025-10-24]
docs/V2/MK6/CAD/Amplification Pad 1088.SLDPRT
5.00 x 21.9 x 0.74 mm
