Global-Health-Labs/NAATOS/docs/V2/MK6/CAD/Backing Card 1088.SLDPRT

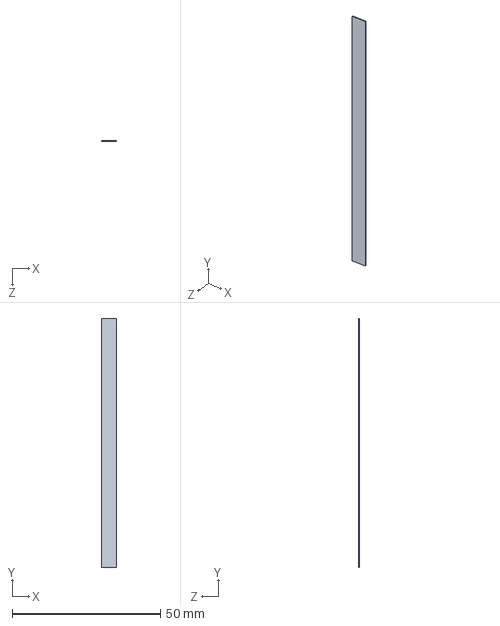
[picture p140: CAD file, 2025-10-24]
docs/V2/MK6/CAD/Backing Card 1088.SLDPRT
5.00 x 84.0 x 0.254 mm
