Global-Health-Labs/NAATOS/docs/V2/MK6/CAD/User Interface Adhesive Layer 1088.SLDPRT

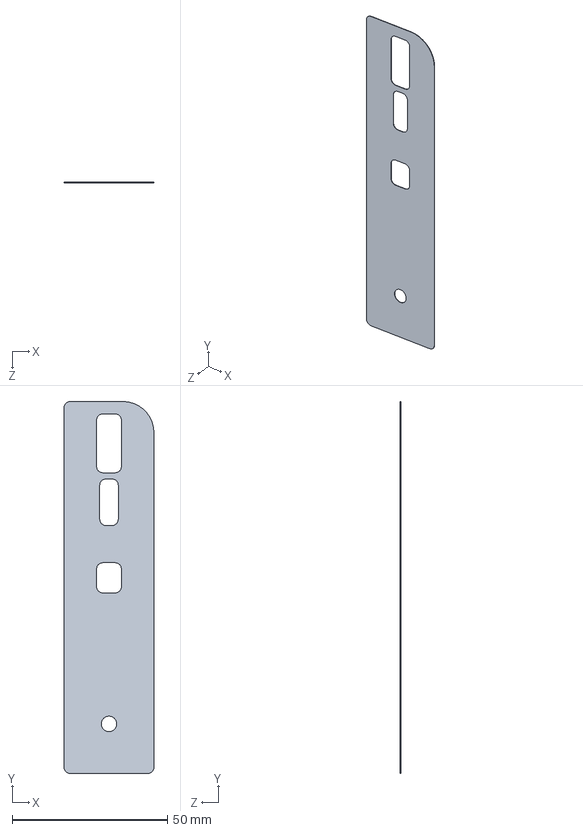
[picture p141: CAD file, 2025-10-24]
docs/V2/MK6/CAD/User Interface Adhesive Layer 1088.SLDPRT
29.0 x 120.0 x 0.17 mm
