Global-Health-Labs/NAATOS/docs/V2/MK6/CAD/Valve Spacer Layer.SLDPRT

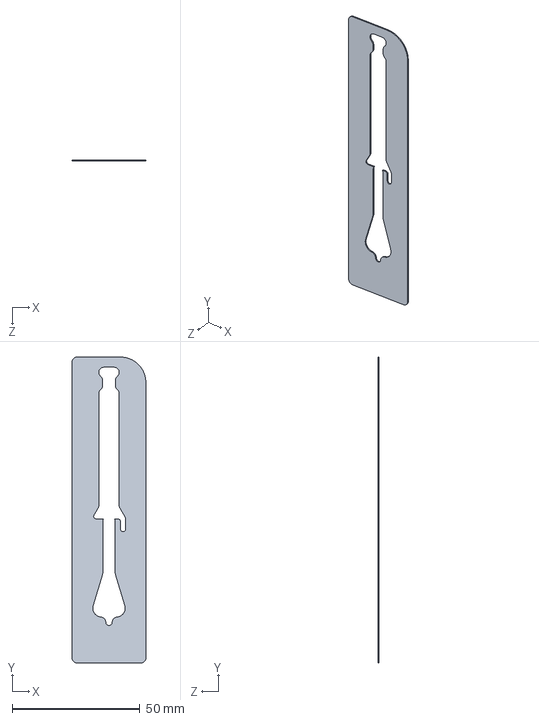
[picture p142: CAD file, 2025-10-24]
docs/V2/MK6/CAD/Valve Spacer Layer.SLDPRT
29.0 x 120.0 x 0.508 mm
