Global-Health-Labs/NAATOS/docs/V2/MK6/CAD/Waste Pad 1088.SLDPRT

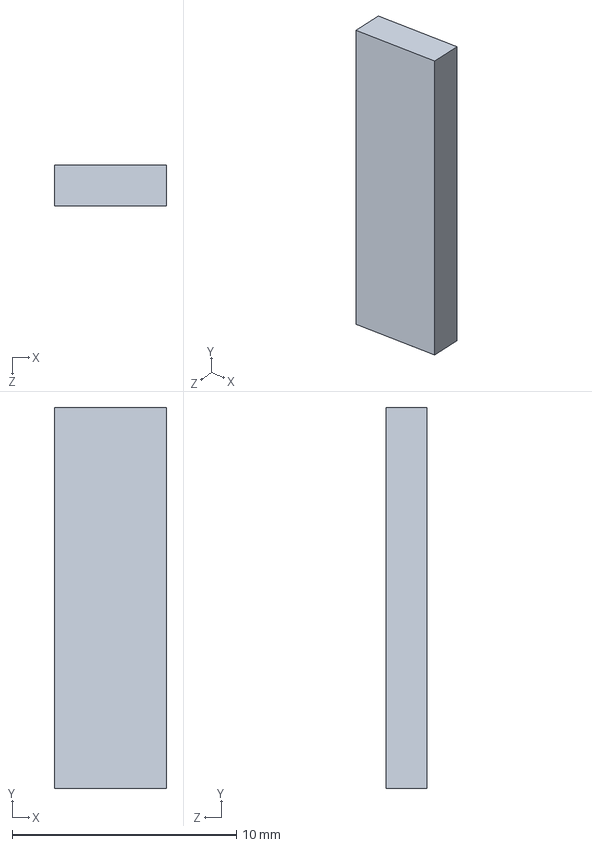
[picture p143: CAD file, 2025-10-24]
docs/V2/MK6/CAD/Waste Pad 1088.SLDPRT
5.00 x 17.0 x 1.82 mm
