Global-Health-Labs/NAATOS/docs/V2/MK6/CAD/Wax Valve 1088.SLDPRT

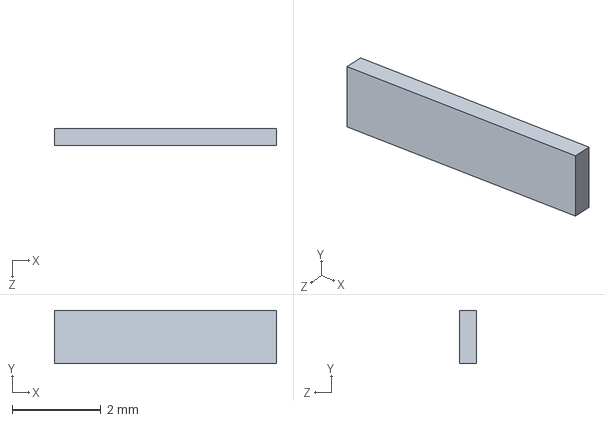
[picture p146: CAD file, 2025-10-24]
docs/V2/MK6/CAD/Wax Valve 1088.SLDPRT
5.00 x 1.20 x 0.38 mm
