Global-Health-Labs/NAATOS/docs/V2/MK8C/CAD/0004-003-00.SLDASM

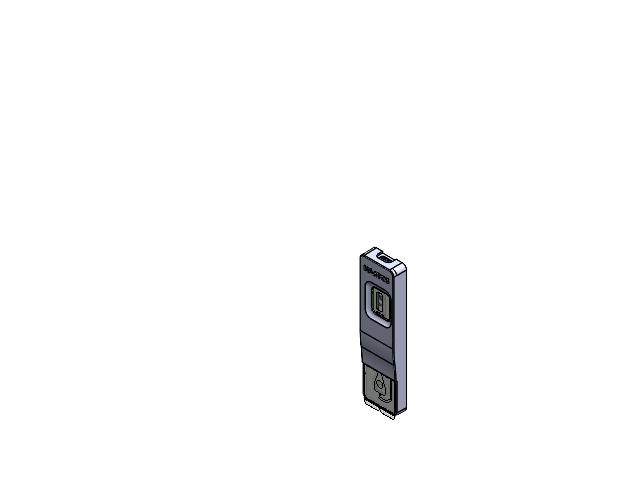
[picture p147: CAD file, 2025-10-29]
docs/V2/MK8C/CAD/0004-003-00.SLDASM
BaseHousingUSB-C
MK8 PCB.step
Consumable Test Device 1088(1× device)
TopHousing_USB-C_V4
