Global-Health-Labs/NAATOS/docs/V2/MK6/CAD/Valve Pad w Wax Valve 1088.SLDASM

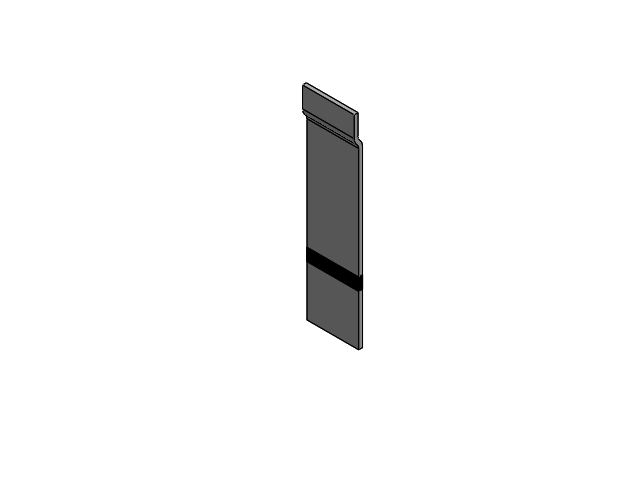
[picture p148: CAD file, 2025-10-24]
docs/V2/MK6/CAD/Valve Pad w Wax Valve 1088.SLDASM
Valve Pad 1088
Wax Valve 1088
