Global-Health-Labs/NAATOS/(list of files, cad)

Other CAD files:
docs/V2/MK6/Derived/0008-007-00.STL
docs/V2/MK8AA/Derived/0017-006-00.STL
docs/V2/MK8C/Derived/0016-005-00.STL
docs/V2/MK6/Derived/0008-009-00.STL
docs/V2/MK8AA/CAD/0017-008-00.SLDPRT
docs/V2/MK8C/CAD/0078-005-00.SLDPRT
docs/V2/MK8AA/CAD/0017-007-00.SLDPRT
docs/V2/MK8C/CAD/0016-006-00.SLDPRT
docs/V2/MK6/CAD/0008-003-00.SLDPRT
docs/V2/MK8AA/CAD/0017-005-00.SLDPRT
docs/V2/MK6/CAD/Test Line 1088.SLDPRT
docs/V2/MK6/CAD/Base Layer 1088.SLDPRT
docs/V2/MK6/CAD/Flow Control Line 1088.SLDPRT
docs/V2/MK6/CAD/0008-004-00.SLDPRT
docs/V2/MK6/CAD/0008-011-00.SLDDRW
docs/V2/MK6/CAD/0008-013-00.SLDDRW
docs/V2/MK6/CAD/0008-014-00.SLDDRW
docs/V2/MK6/CAD/0008-015-00.SLDDRW
docs/V2/MK6/CAD/0008-016-00.SLDDRW
docs/V2/MK6/CAD/0008-017-00.SLDDRW
docs/V2/MK6/CAD/0008-018-00.SLDDRW
docs/V2/MK6/CAD/0008-019-00.SLDDRW
docs/V2/MK8AA/CAD/0017-011-00.SLDDRW
docs/V2/MK8AA/CAD/0017-013-00.SLDDRW
docs/V2/MK8AA/CAD/0017-014-00.SLDDRW
docs/V2/MK8AA/CAD/0017-015-00.SLDDRW
docs/V2/MK8AA/CAD/0017-016-00.SLDDRW
docs/V2/MK8AA/CAD/0017-017-00.SLDDRW
docs/V2/MK8AA/CAD/0017-018-00.SLDDRW
docs/V2/MK8C/CAD/0016-011-00.SLDDRW
docs/V2/MK8C/CAD/0016-015-00.SLDDRW
docs/V2/MK8C/CAD/0016-016-00.SLDDRW
