Global-Health-Labs/NAATOS/docs/V2/MK6/Drawings/0008-011-00.pdf

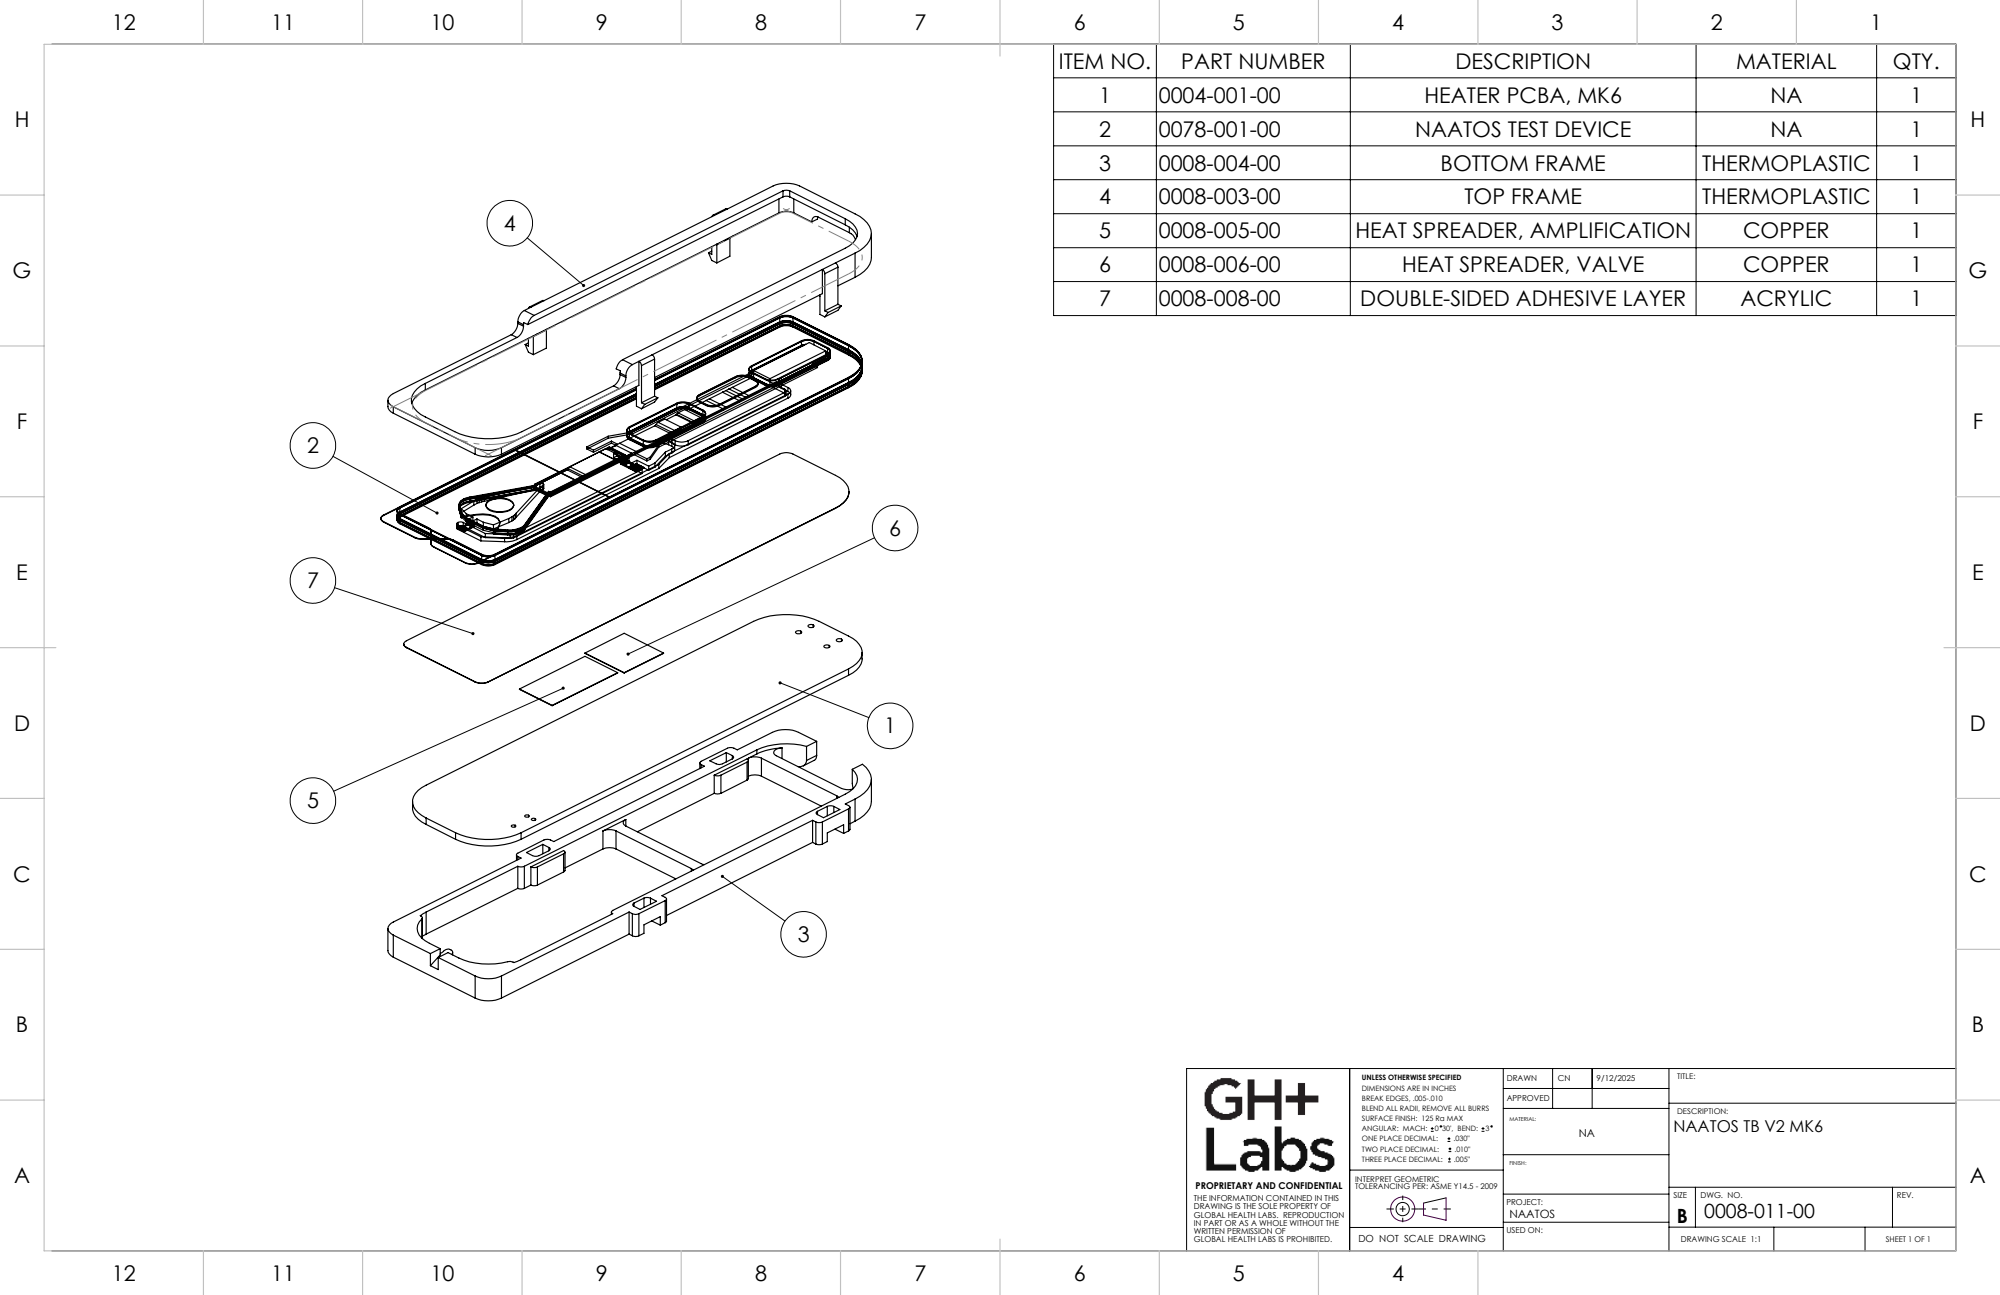
[picture p149: page 1]
SHEET 1 OF 1; DRAWING SCALE 1:1; DWG. NO.; UNLESS OTHERWISE SPECIFIED; ONE PLACE DECIMAL:; TWO PLACE DECIMAL:; NAATOS TB V2 MK6; USED ON:

ITEM NO. | PART NUMBER | DESCRIPTION | MATERIAL | QTY.
1 | 0004-001-00 | HEATER PCBA, MK6 | NA | 1
2 | 0078-001-00 | NAATOS TEST DEVICE | NA | 1
3 | 0008-004-00 | BOTTOM FRAME | THERMOPLASTIC | 1
4 | 0008-003-00 | TOP FRAME | THERMOPLASTIC | 1
5 | 0008-005-00 | HEAT SPREADER, AMPLIFICATION | COPPER | 1
6 | 0008-006-00 | HEAT SPREADER, VALVE | COPPER | 1
7 | 0008-008-00 | DOUBLE-SIDED ADHESIVE LAYER | ACRYLIC | 1

DIMENSIONS ARE IN INCHES
BREAK EDGES, .005-.010
BLEND ALL RADII, REMOVE ALL BURRS
SURFACE FINISH: 125 Ra MAX
ANGULAR: MACH: 0 30', BEND: 3
THREE PLACE DECIMAL: .005"
INTERPRET GEOMETRIC
TOLERANCING PER: ASME Y14.5 - 2009

PROPRIETARY AND CONFIDENTIAL
THE INFORMATION CONTAINED IN THIS
DRAWING IS THE SOLE PROPERTY OF
GLOBAL HEALTH LABS. REPRODUCTION
IN PART OR AS A WHOLE WITHOUT THE
WRITTEN PERMISSION OF
GLOBAL HEALTH LABS IS PROHIBITED.

DO NOT SCALE DRAWING
