Global-Health-Labs/NAATOS/docs/V2/MK6/Drawings/0008-013-00.pdf

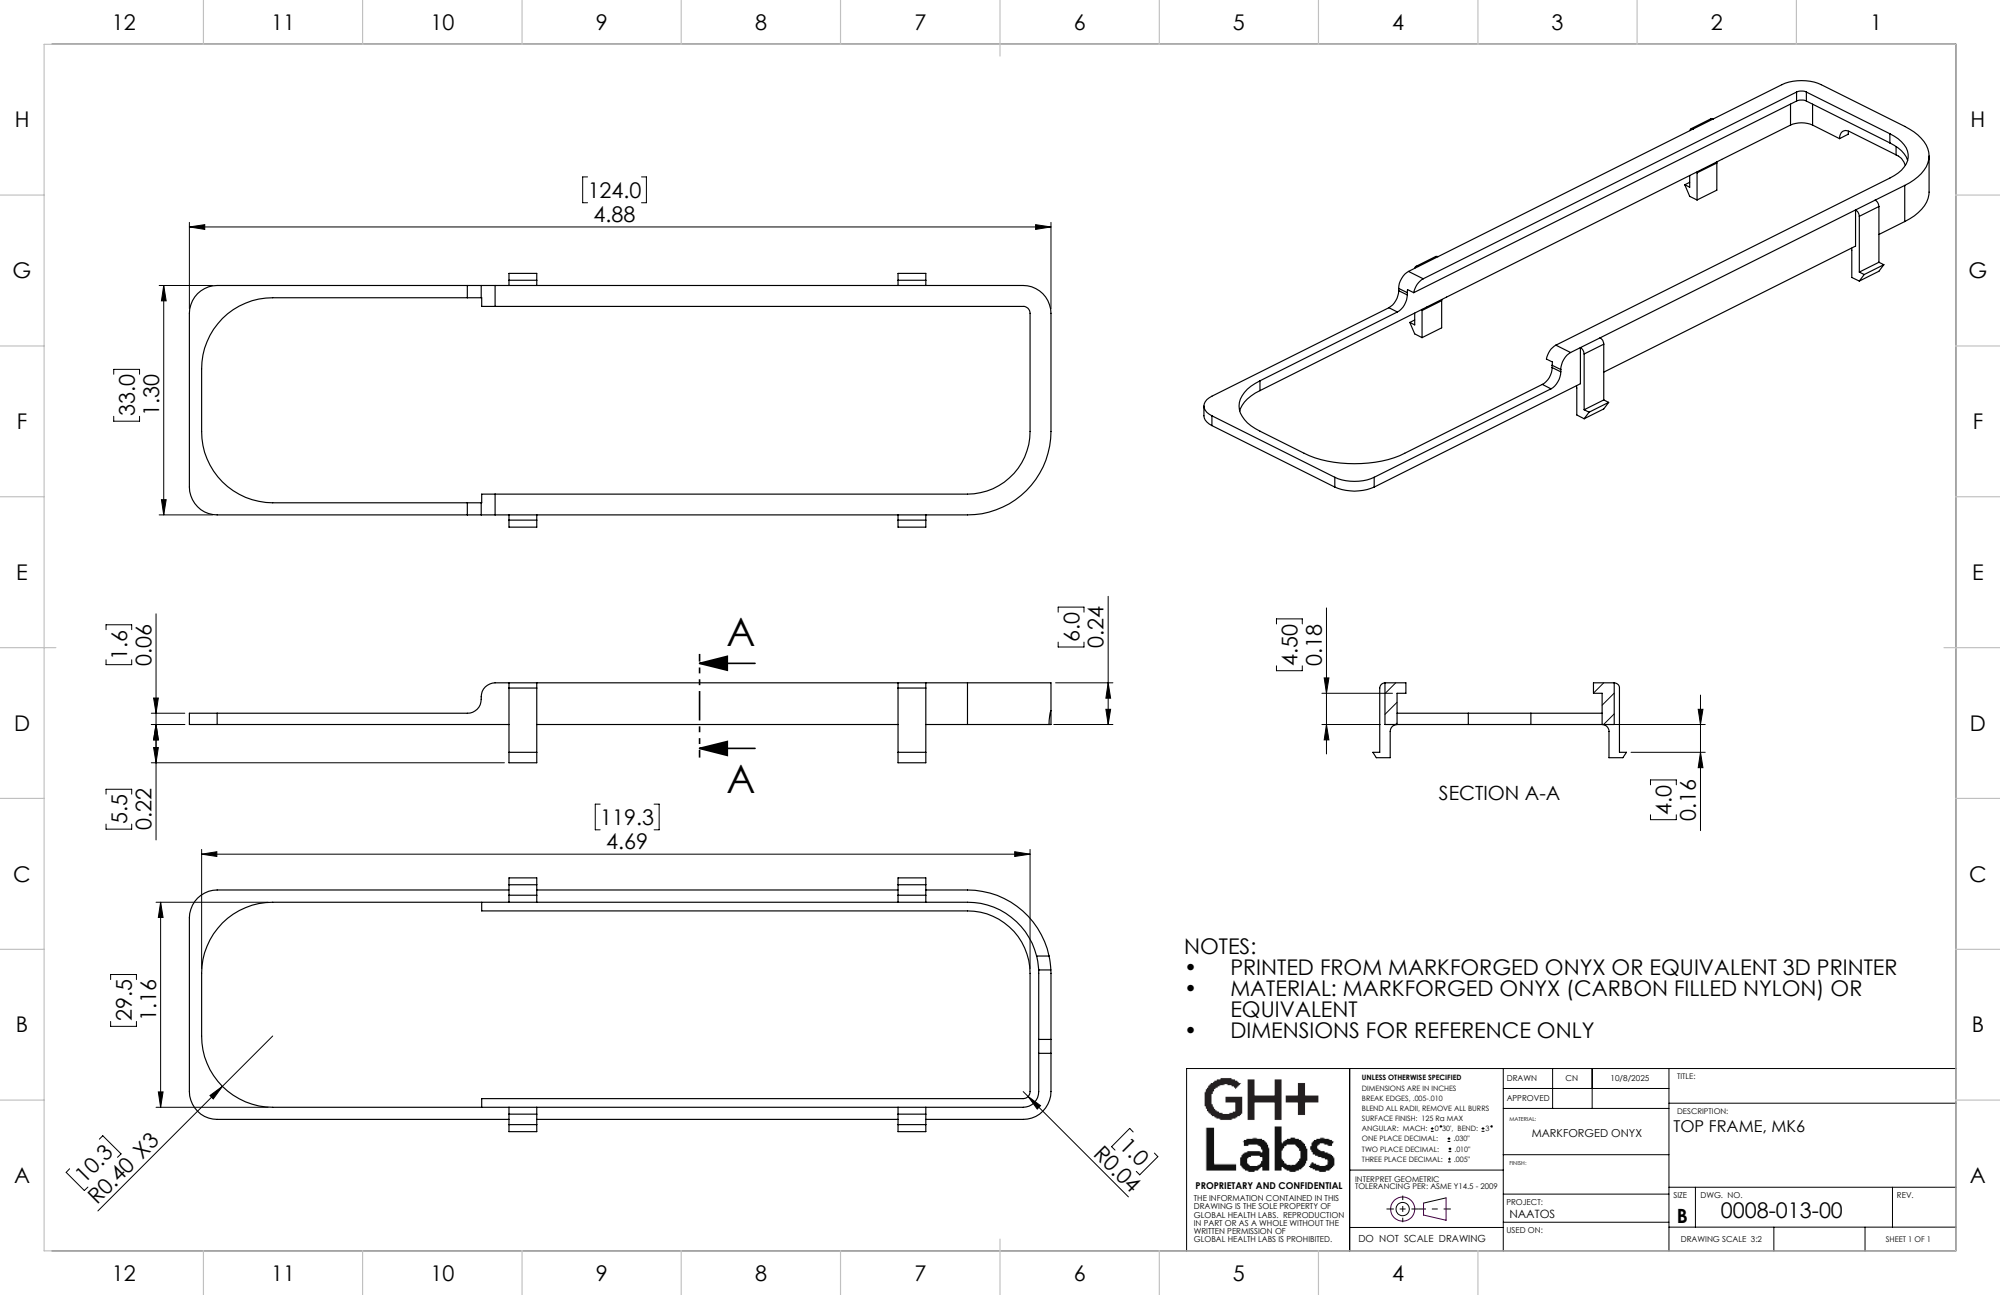
[picture p150: page 1]
SECTION A-A; SHEET 1 OF 1; DRAWING SCALE 3:2; MARKFORGED ONYX; DWG. NO.; UNLESS OTHERWISE SPECIFIED; ONE PLACE DECIMAL:; TWO PLACE DECIMAL:; TOP FRAME, MK6; USED ON:

NOTES:
• PRINTED FROM MARKFORGED ONYX OR EQUIVALENT 3D PRINTER • MATERIAL: MARKFORGED ONYX (CARBON FILLED NYLON) OR
EQUIVALENT • DIMENSIONS FOR REFERENCE ONLY

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

DO NOT SCALE DRAWING
