Global-Health-Labs/NAATOS/docs/V2/MK6/Drawings/0008-015-00.pdf

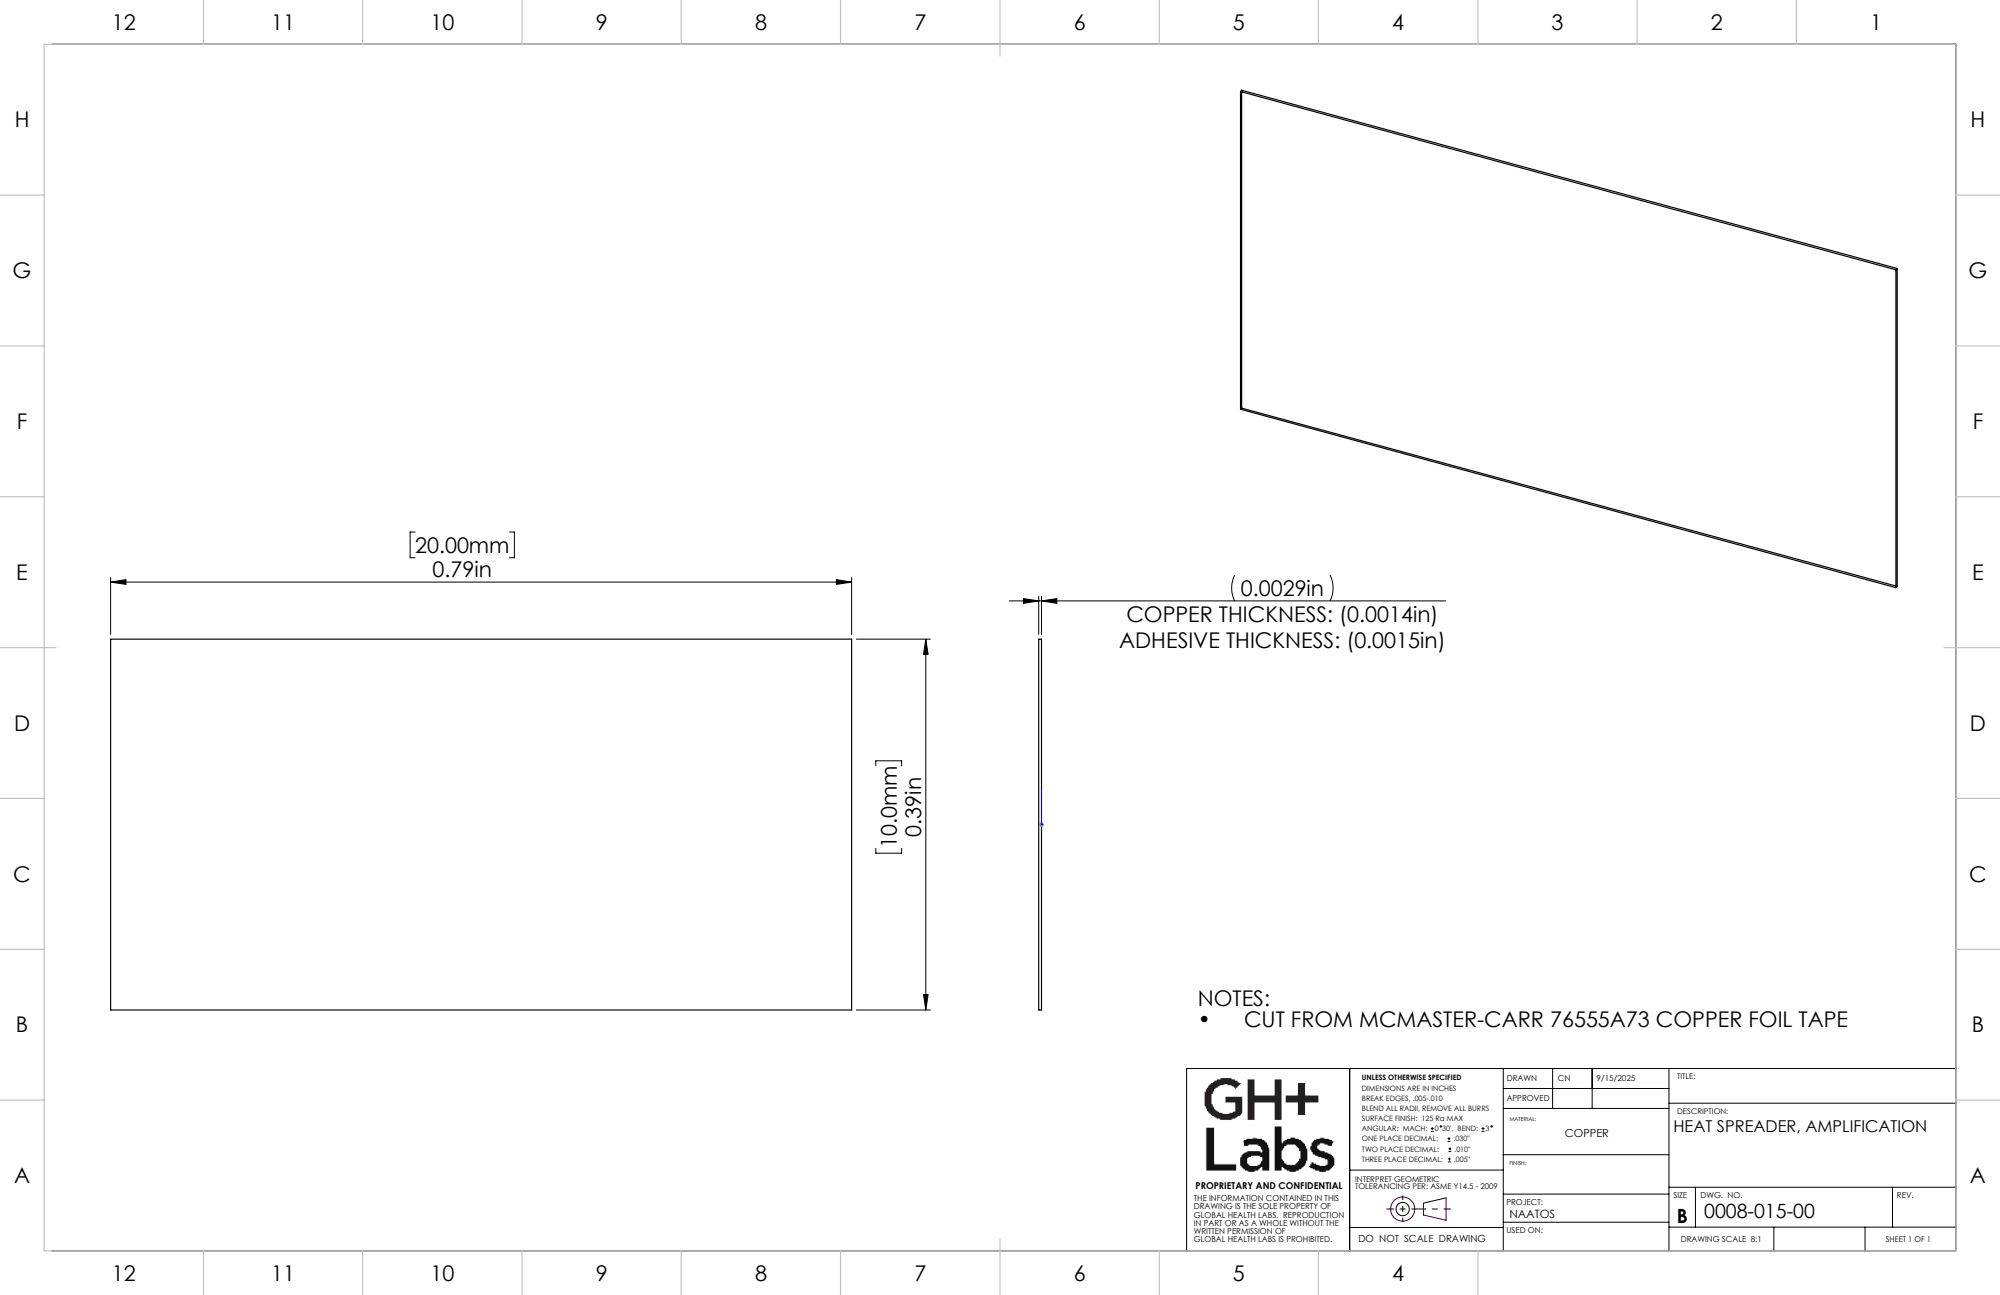
[picture p151: page 1]
COPPER THICKNESS: (0.0014in) ADHESIVE THICKNESS: (0.0015in); SHEET 1 OF 1; DRAWING SCALE 8:1; DWG. NO.; UNLESS OTHERWISE SPECIFIED; ONE PLACE DECIMAL:; TWO PLACE DECIMAL:; USED ON:

NOTES:
• CUT FROM MCMASTER-CARR 76555A73 COPPER FOIL TAPE

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

DESCRIPTION:
HEAT SPREADER, AMPLIFICATION

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

DO NOT SCALE DRAWING
