Global-Health-Labs/NAATOS/docs/V2/MK6/Drawings/0008-018-00.pdf

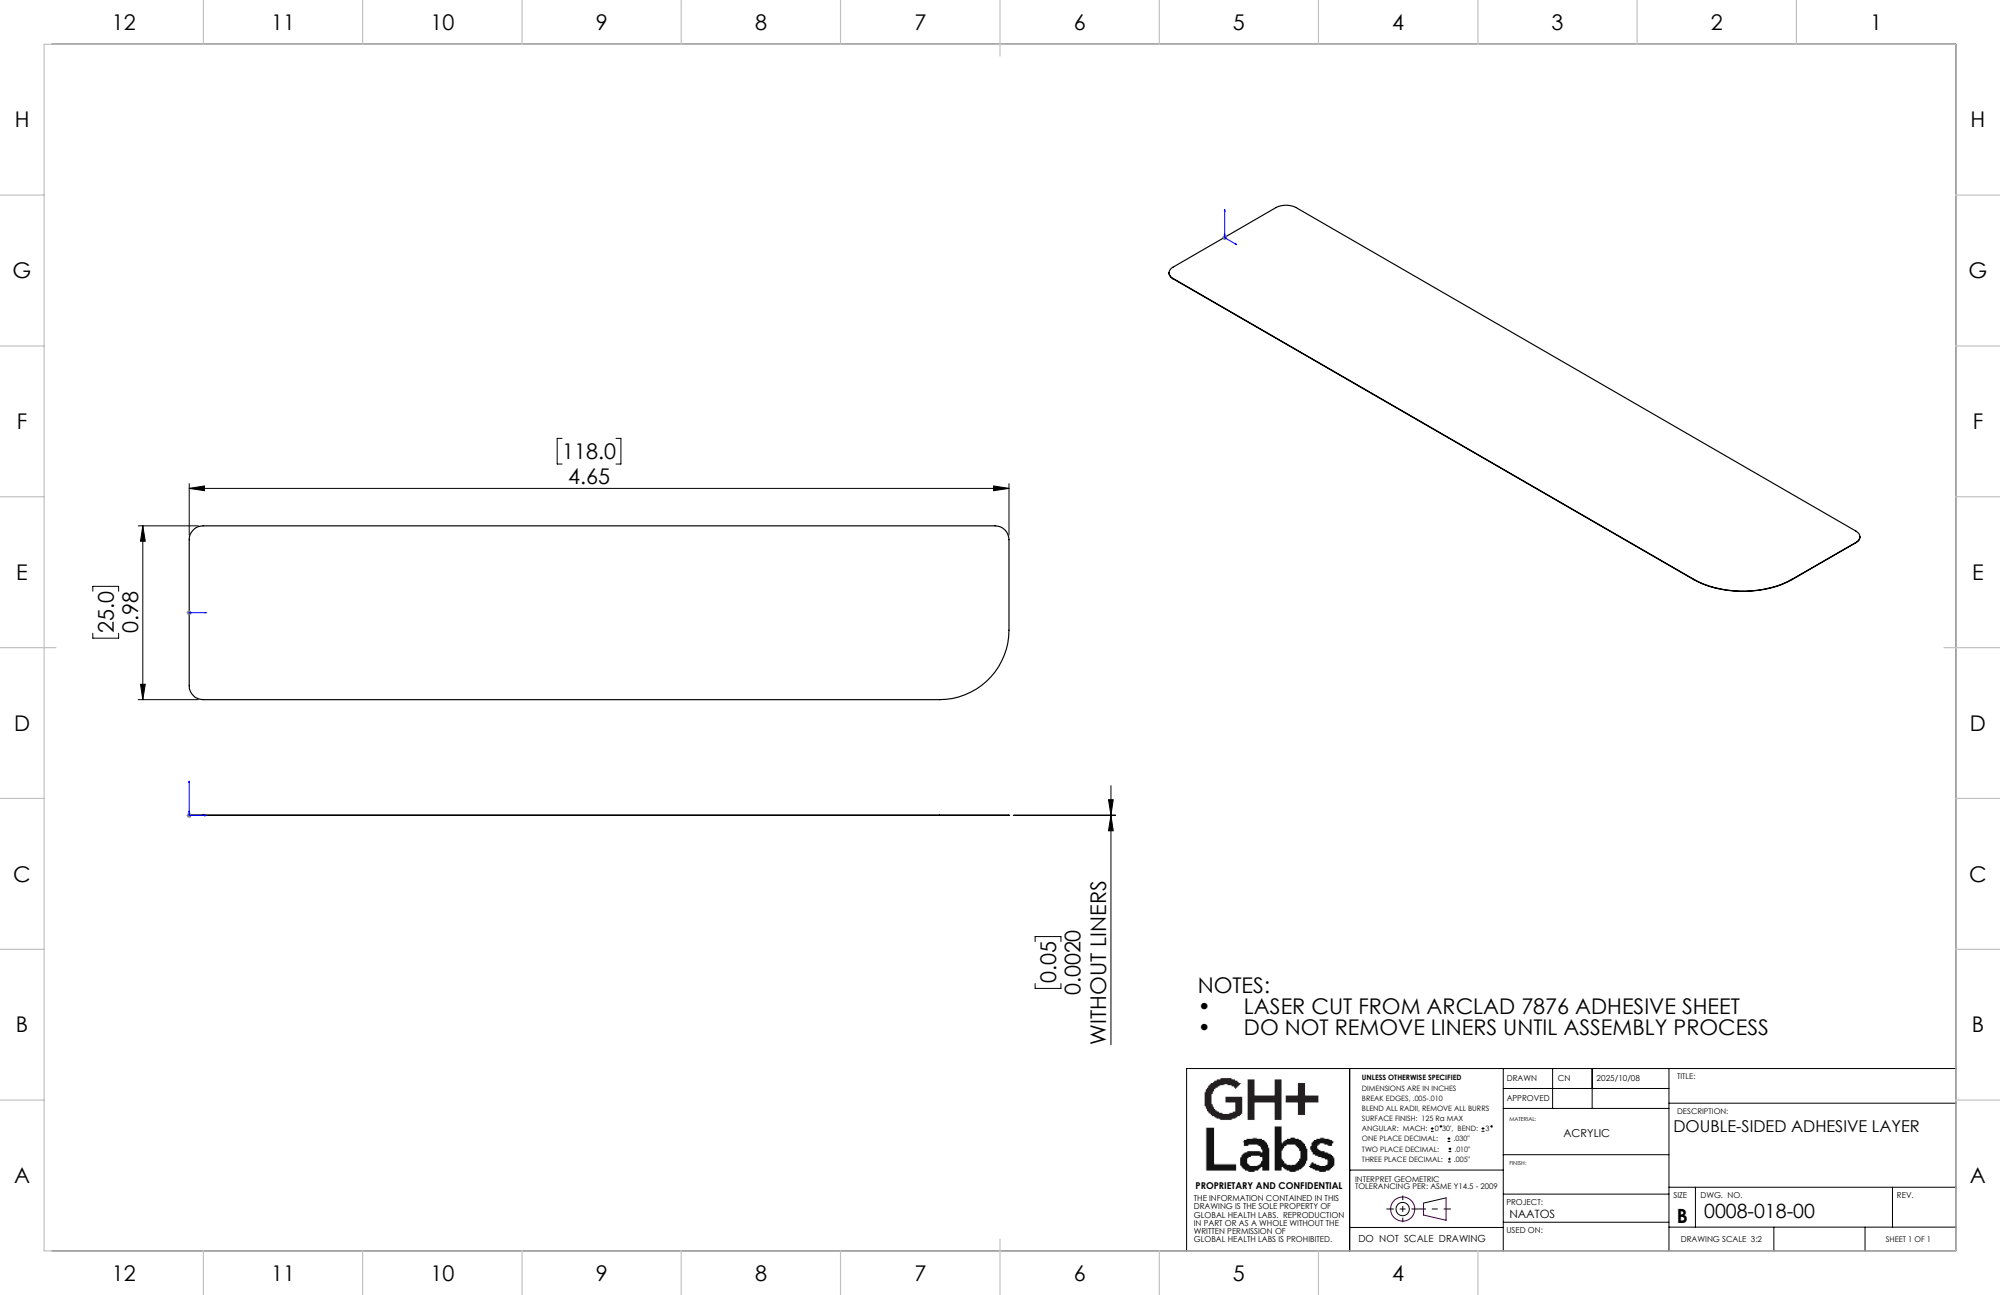
[picture p152: page 1]
WITHOUT LINERS; SHEET 1 OF 1; DRAWING SCALE 3:2; DWG. NO.; UNLESS OTHERWISE SPECIFIED; ONE PLACE DECIMAL:; TWO PLACE DECIMAL:; USED ON:

NOTES:
• LASER CUT FROM ARCLAD 7876 ADHESIVE SHEET • DO NOT REMOVE LINERS UNTIL ASSEMBLY PROCESS

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

DESCRIPTION:
DOUBLE-SIDED ADHESIVE LAYER

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

DO NOT SCALE DRAWING
