Global-Health-Labs/NAATOS/docs/V2/MK8AA/Drawings/0017-011-00.pdf

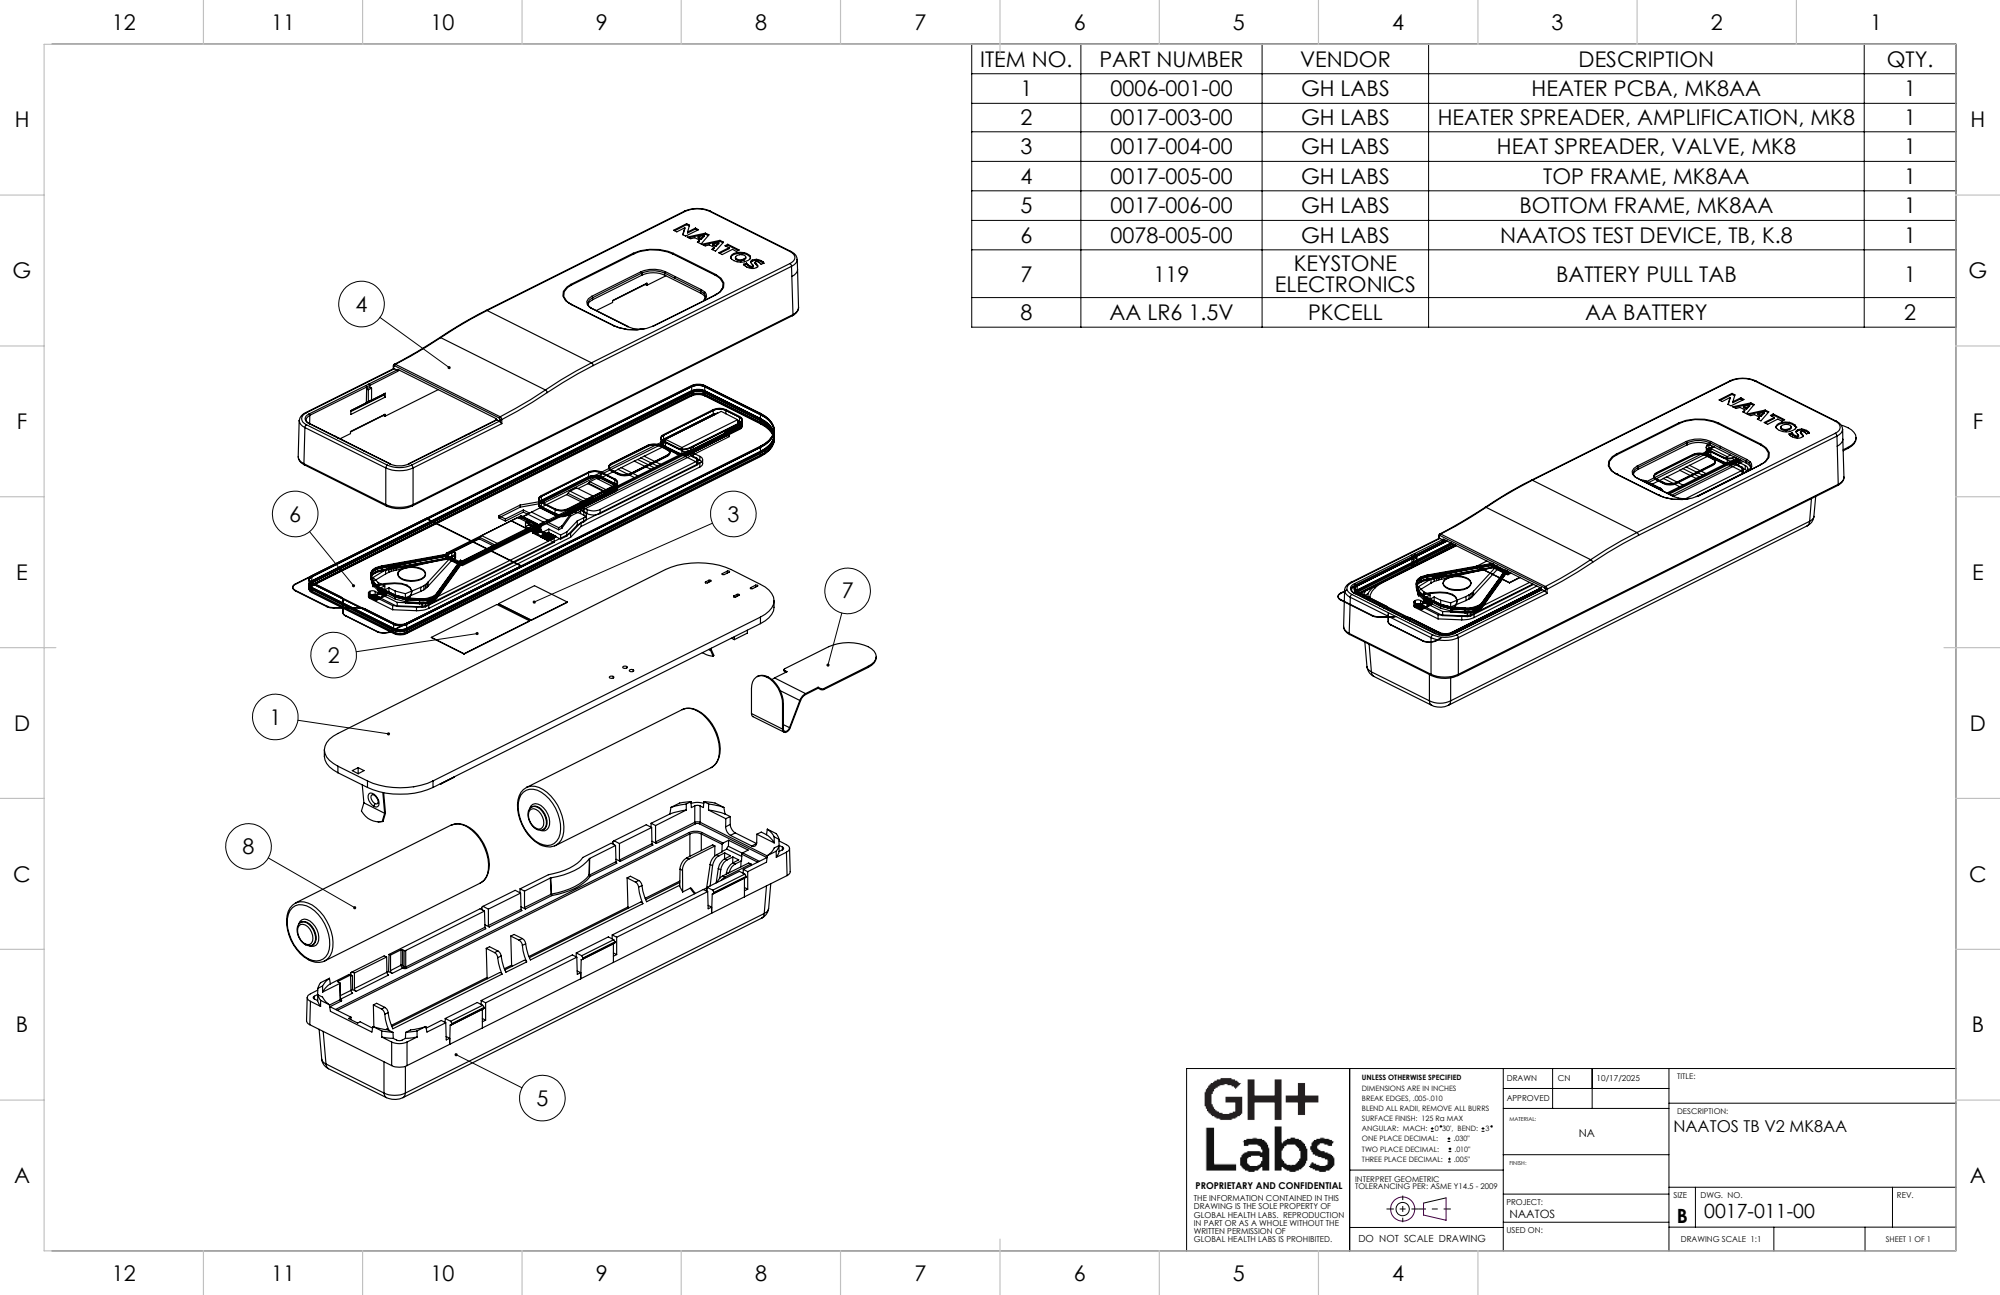
[picture p153: page 1]
SHEET 1 OF 1; DRAWING SCALE 1:1; DWG. NO.; UNLESS OTHERWISE SPECIFIED; ONE PLACE DECIMAL:; TWO PLACE DECIMAL:; NAATOS TB V2 MK8AA; USED ON:

ITEM NO. | PART NUMBER | VENDOR | DESCRIPTION | QTY.
1 | 0006-001-00 | GH LABS | HEATER PCBA, MK8AA | 1
2 | 0017-003-00 | GH LABS | HEATER SPREADER, AMPLIFICATION, MK8 | 1
3 | 0017-004-00 | GH LABS | HEAT SPREADER, VALVE, MK8 | 1
4 | 0017-005-00 | GH LABS | TOP FRAME, MK8AA | 1
5 | 0017-006-00 | GH LABS | BOTTOM FRAME, MK8AA | 1
6 | 0078-005-00 | GH LABS | NAATOS TEST DEVICE, TB, K.8 | 1
7 | 119 | KEYSTONE ELECTRONICS | BATTERY PULL TAB | 1
8 | AA LR6 1.5V | PKCELL | AA BATTERY | 2

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

DO NOT SCALE DRAWING
