Global-Health-Labs/NAATOS/docs/V2/MK8AA/Drawings/0017-015-00.pdf

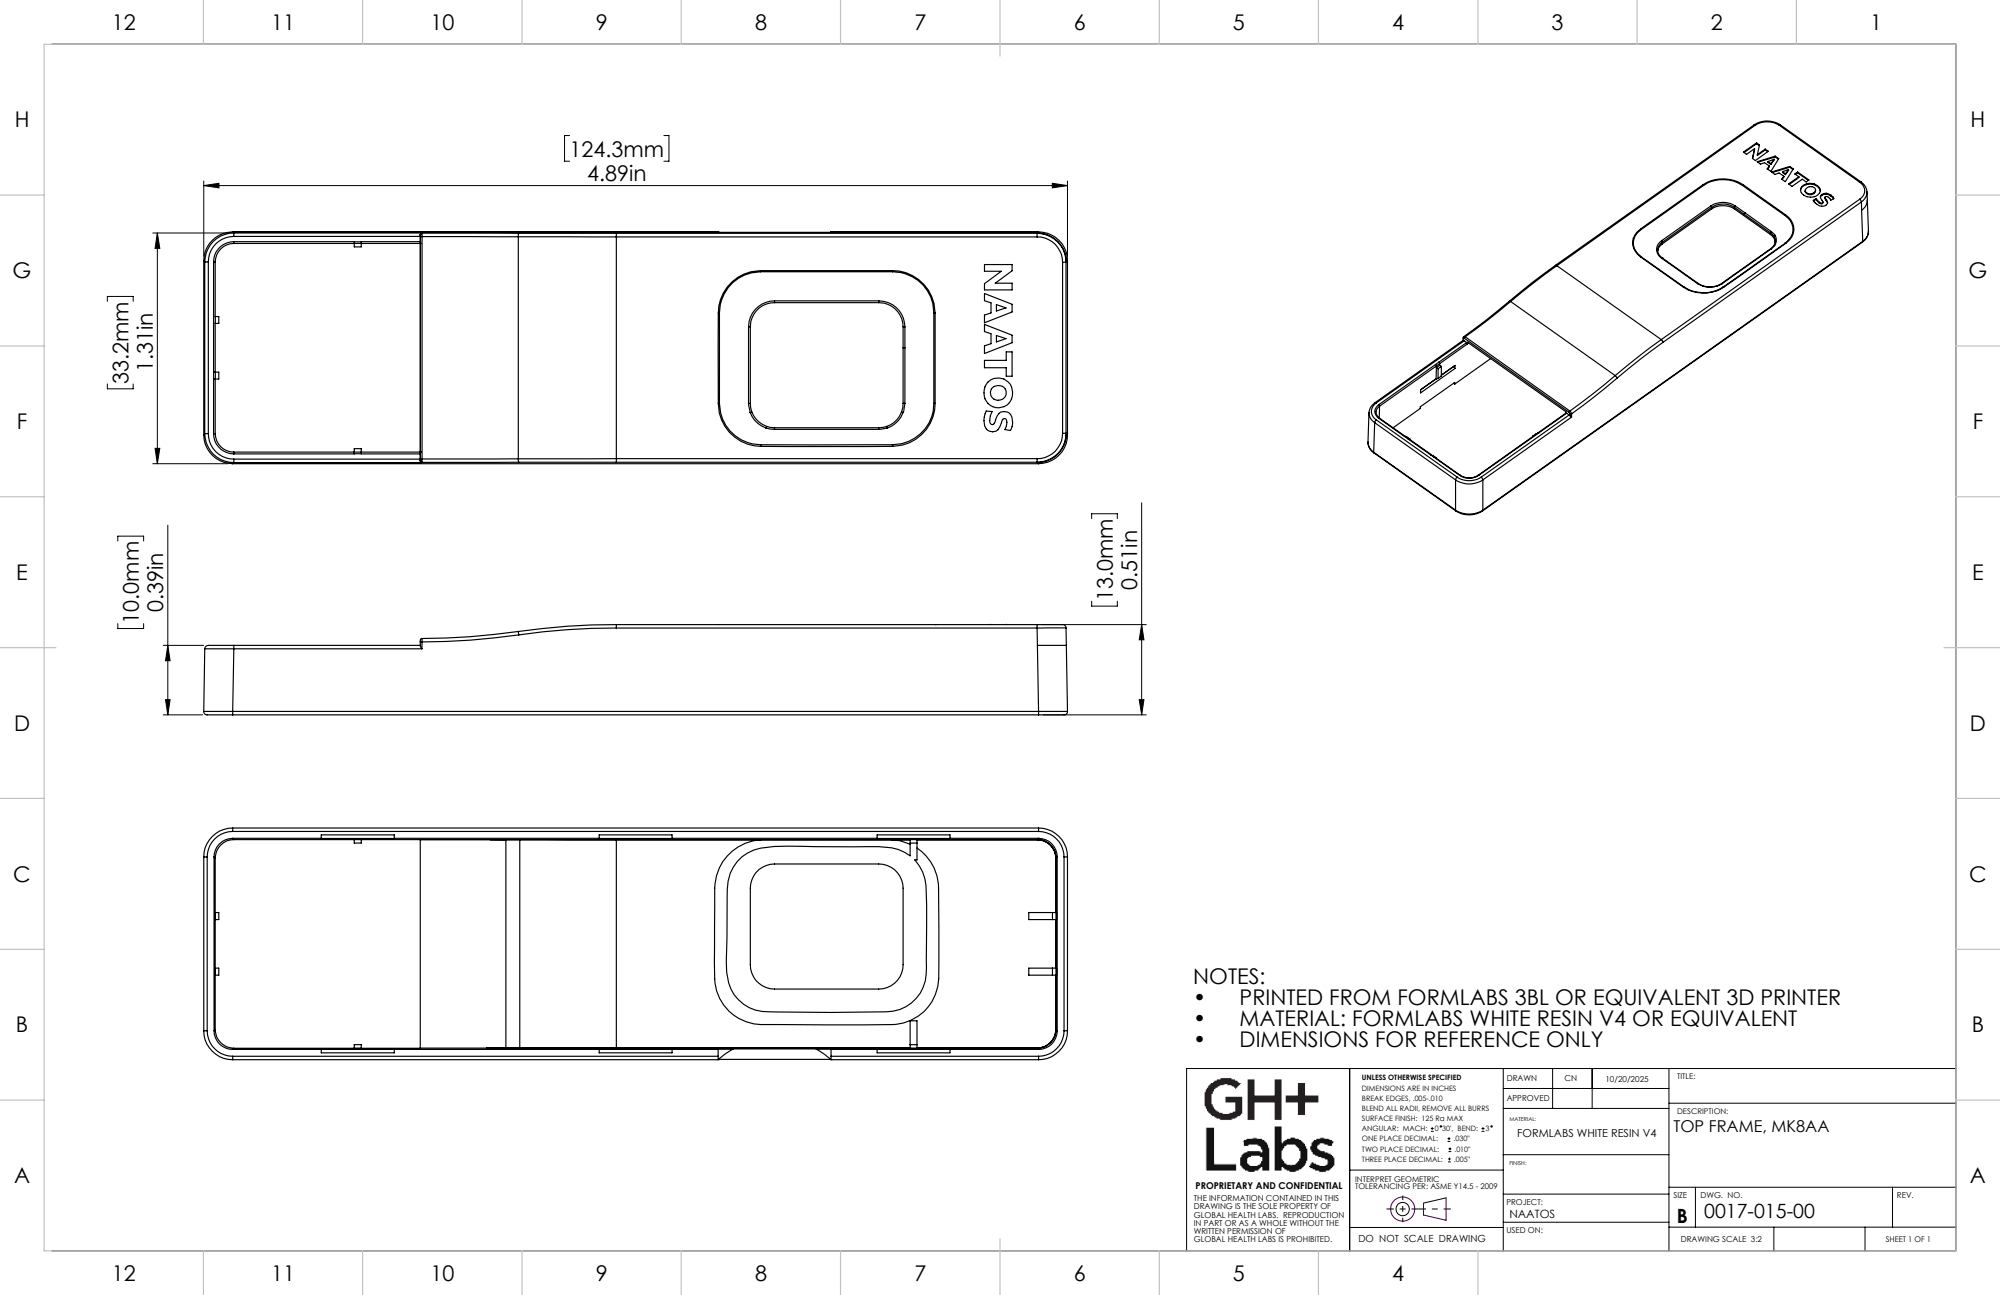
[picture p154: page 1]
SHEET 1 OF 1; DRAWING SCALE 3:2; DWG. NO.; UNLESS OTHERWISE SPECIFIED; ONE PLACE DECIMAL:; TWO PLACE DECIMAL:; TOP FRAME, MK8AA; USED ON:

NOTES:
• PRINTED FROM FORMLABS 3BL OR EQUIVALENT 3D PRINTER • MATERIAL: FORMLABS WHITE RESIN V4 OR EQUIVALENT • DIMENSIONS FOR REFERENCE ONLY

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

MATERIAL:
FORMLABS WHITE RESIN V4

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

DO NOT SCALE DRAWING
