Global-Health-Labs/NAATOS/docs/V2/MK8C/Drawings/0016-011-00.pdf

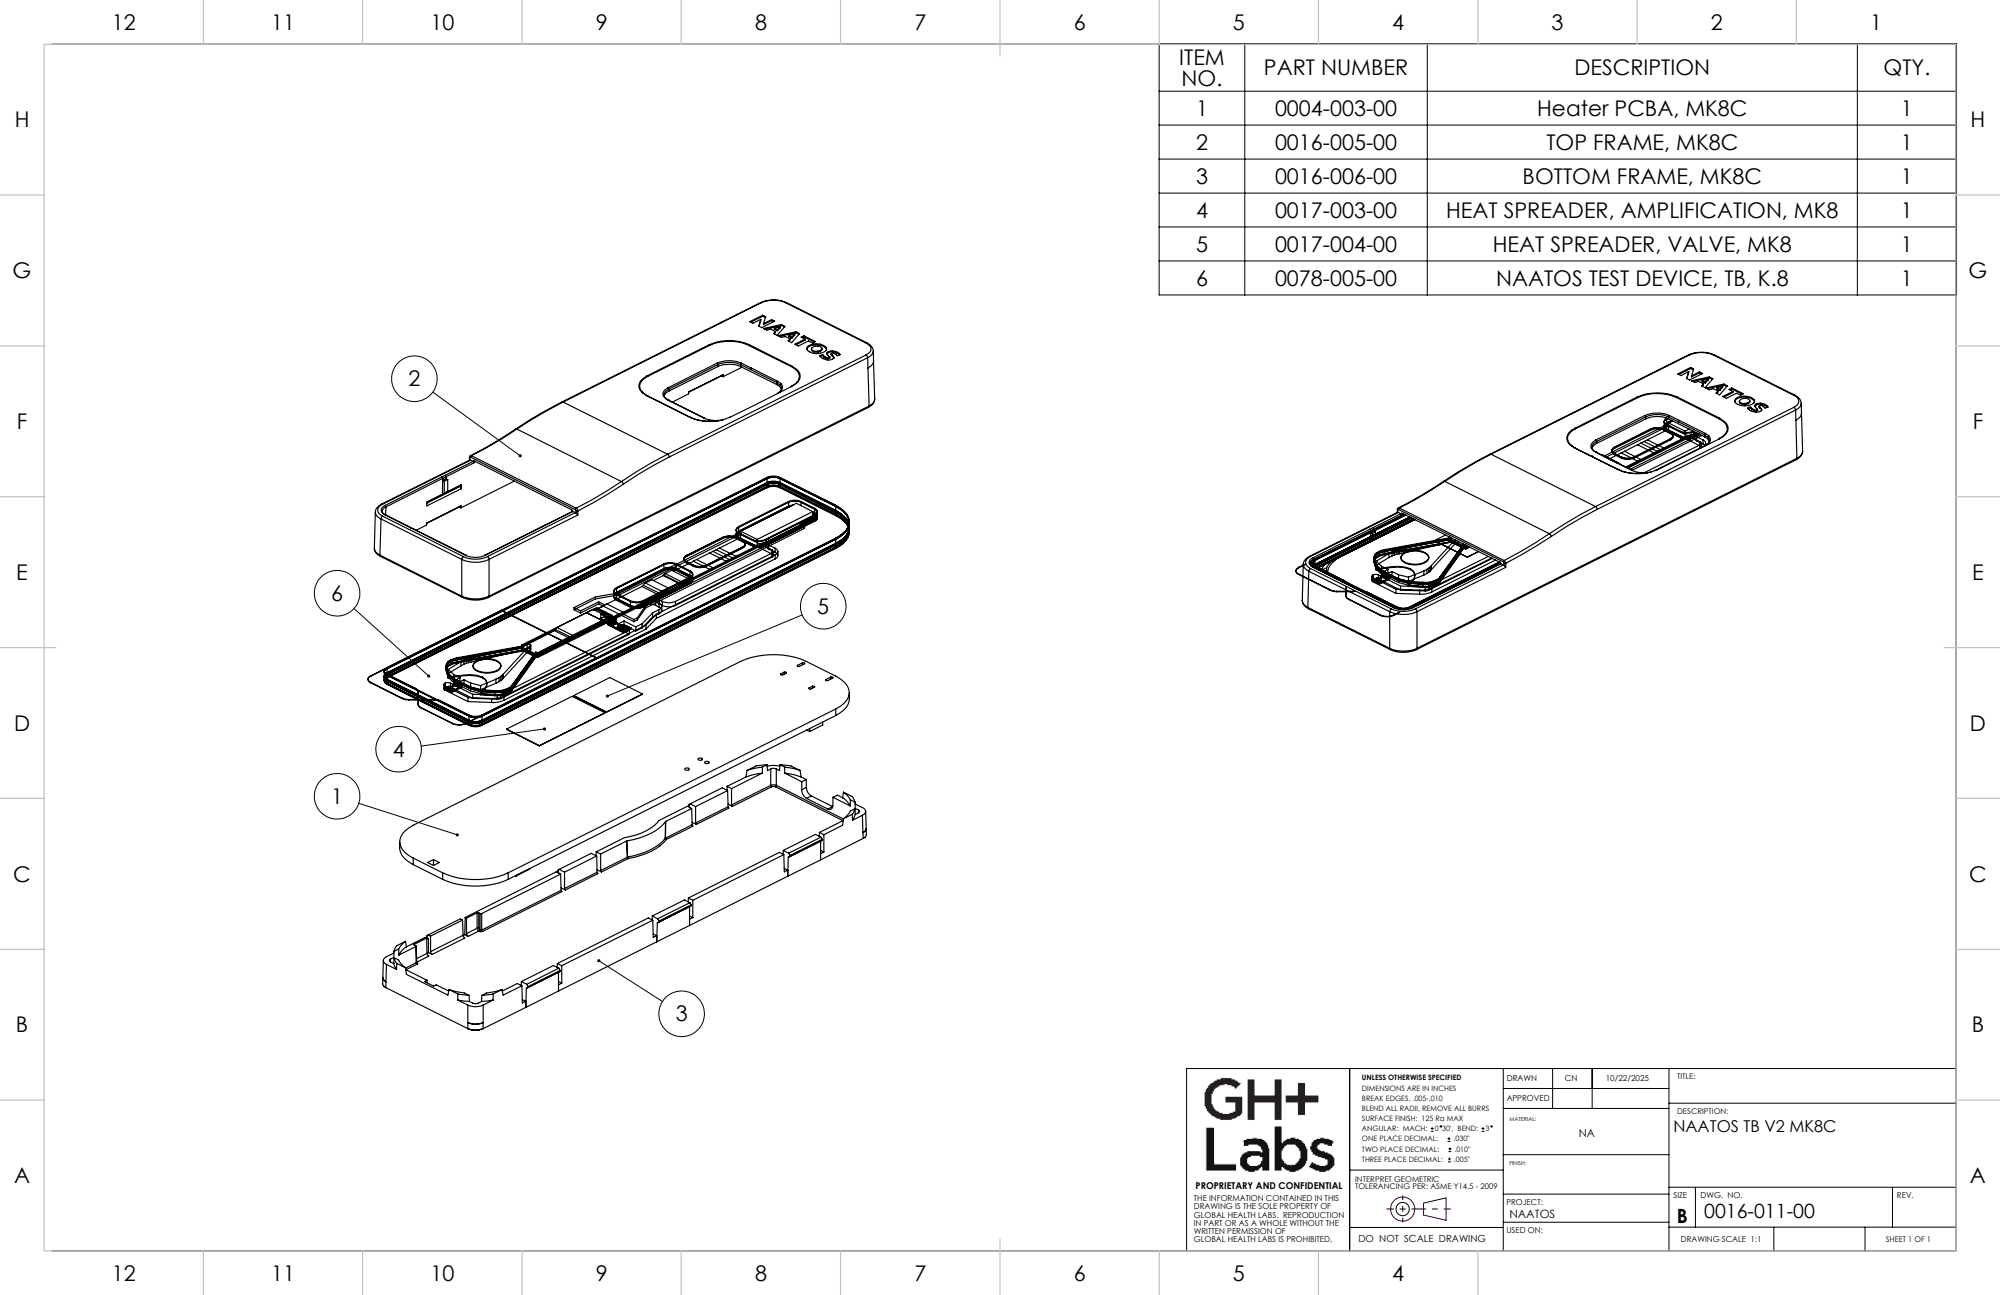
[picture p155: page 1]
SHEET 1 OF 1; DRAWING SCALE 1:1; DWG. NO.; UNLESS OTHERWISE SPECIFIED; ONE PLACE DECIMAL:; TWO PLACE DECIMAL:; NAATOS TB V2 MK8C; USED ON:

ITEM NO. | PART NUMBER | DESCRIPTION | QTY.
1 | 0004-003-00 | Heater PCBA, MK8C | 1
2 | 0016-005-00 | TOP FRAME, MK8C | 1
3 | 0016-006-00 | BOTTOM FRAME, MK8C | 1
4 | 0017-003-00 | HEAT SPREADER, AMPLIFICATION, MK8 | 1
5 | 0017-004-00 | HEAT SPREADER, VALVE, MK8 | 1
6 | 0078-005-00 | NAATOS TEST DEVICE, TB, K.8 | 1

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

DO NOT SCALE DRAWING
