Global-Health-Labs/NAATOS/docs/V2/MK8AA/Drawings/119.PDF

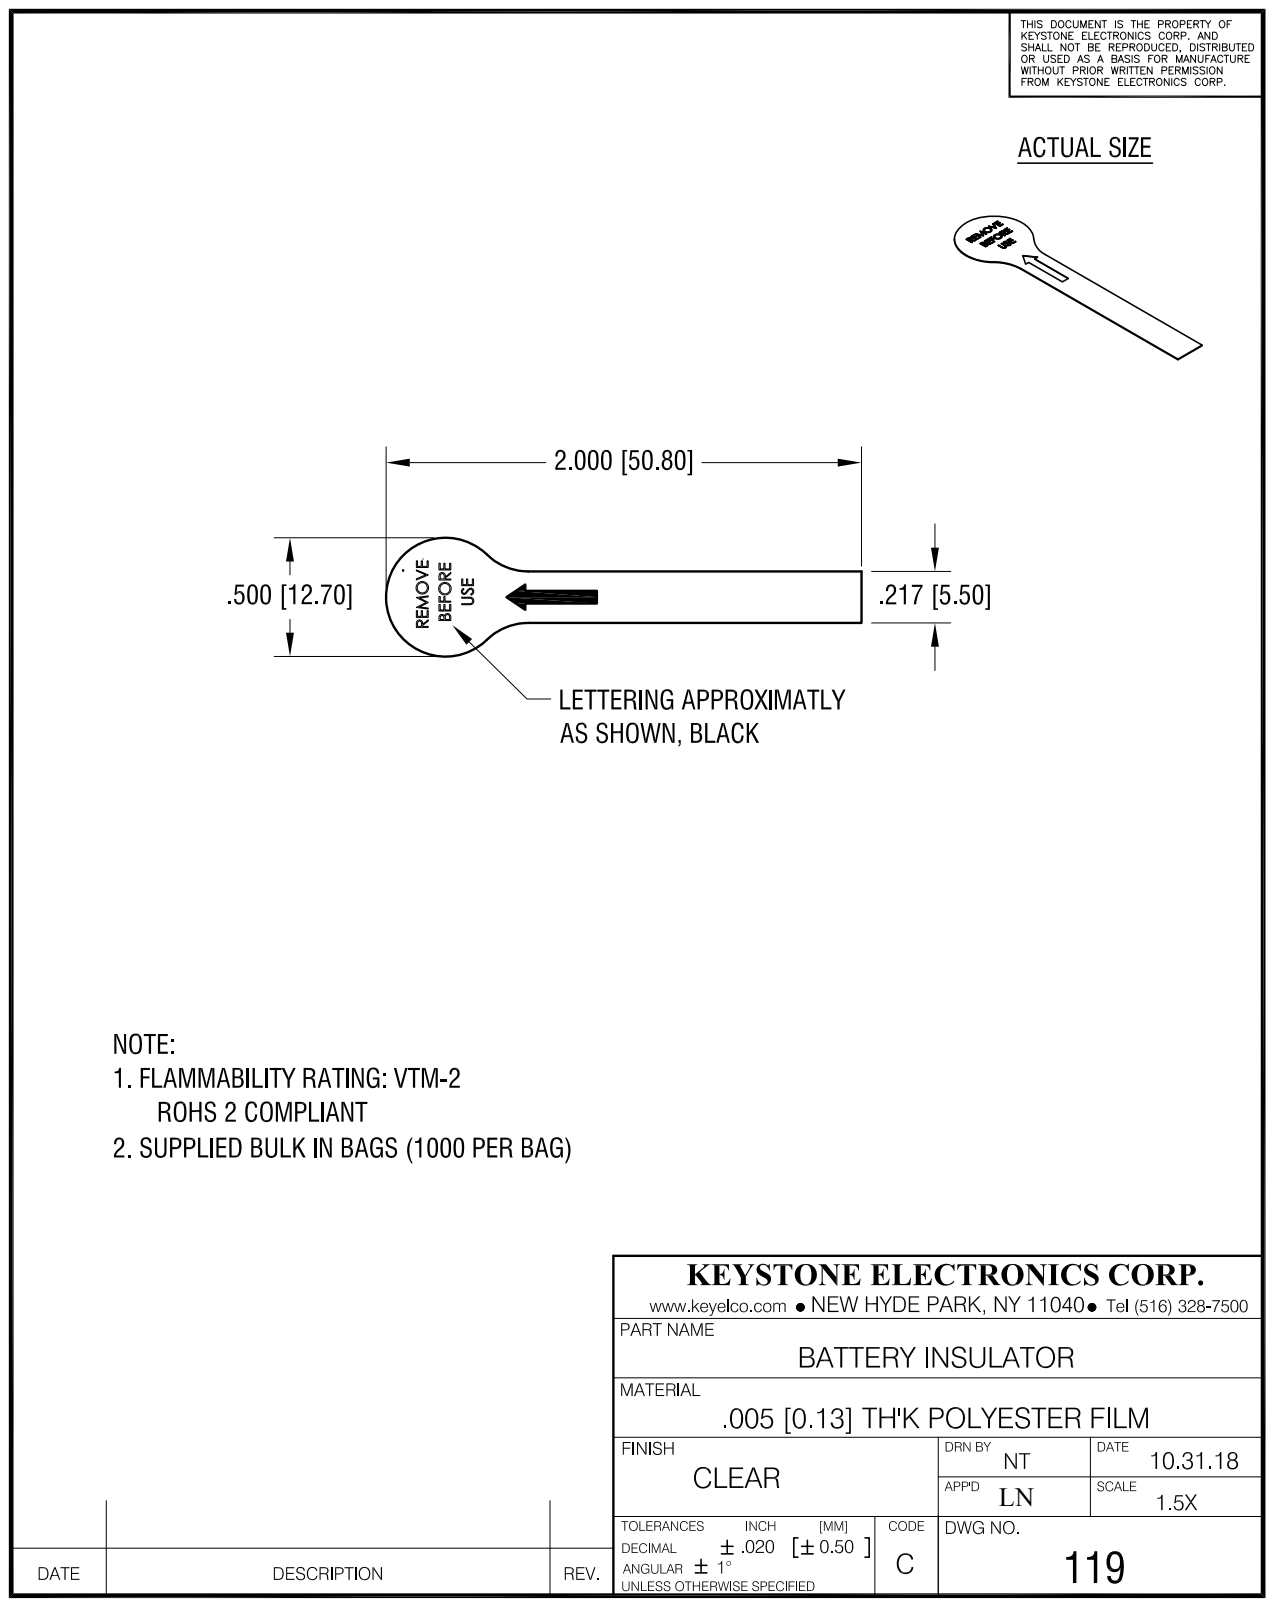
[picture p156: page 1]
