Global-Health-Labs/NAATOS/(commit log)

2025-10-24 First commit mk6 CAD
    [0008-001-00.SLDDRW, 0008-003-00.SLDDRW, 0008-003-00.SLDPRT, 0008-004-00.SLDDRW, 0008-004-00.SLDPRT, 0008-005-00.SLDDRW, 0008-005-00.SLDPRT, 0008-006-00.SLDDRW]
2025-10-24 Add team, risk, RTM sections
    [NAATOS-TB-V1-risk.csv, NAATOS-TB-V1-rtm-mr18.csv, NAATOS-TB-V1-rtm-mr19.csv, NAATOS-TB-V1-rtm-mr20.csv, NAATOS-TB-V1-rtm-mr21.csv, NAATOS-TB-V1-rtm-mr22.csv, NAATOS-TB-V1-rtm-mr23.csv, NAATOS-TB-V1-rtm-mr24.csv]
2025-10-29 Add Usability to docs and minor updates to other docs pages
    [NAATOS-TB-V1-usability.csv]
2026-02-14 Revert to Material
