Global-Health-Labs/NAATOS/docs/V2/MK6/CAD/0008-006-00.SLDPRT

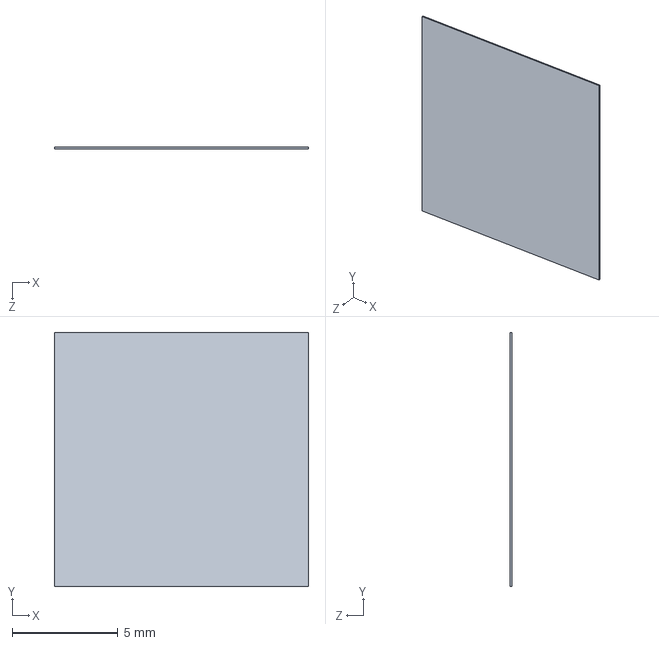
[picture p1: CAD file, 2025-10-24]
docs/V2/MK6/CAD/0008-006-00.SLDPRT
12.0 x 12.0 x 0.0737 mm
