Global-Health-Labs/NAATOS/docs/V2/MK8AA/Drawings/0017-013-00.pdf

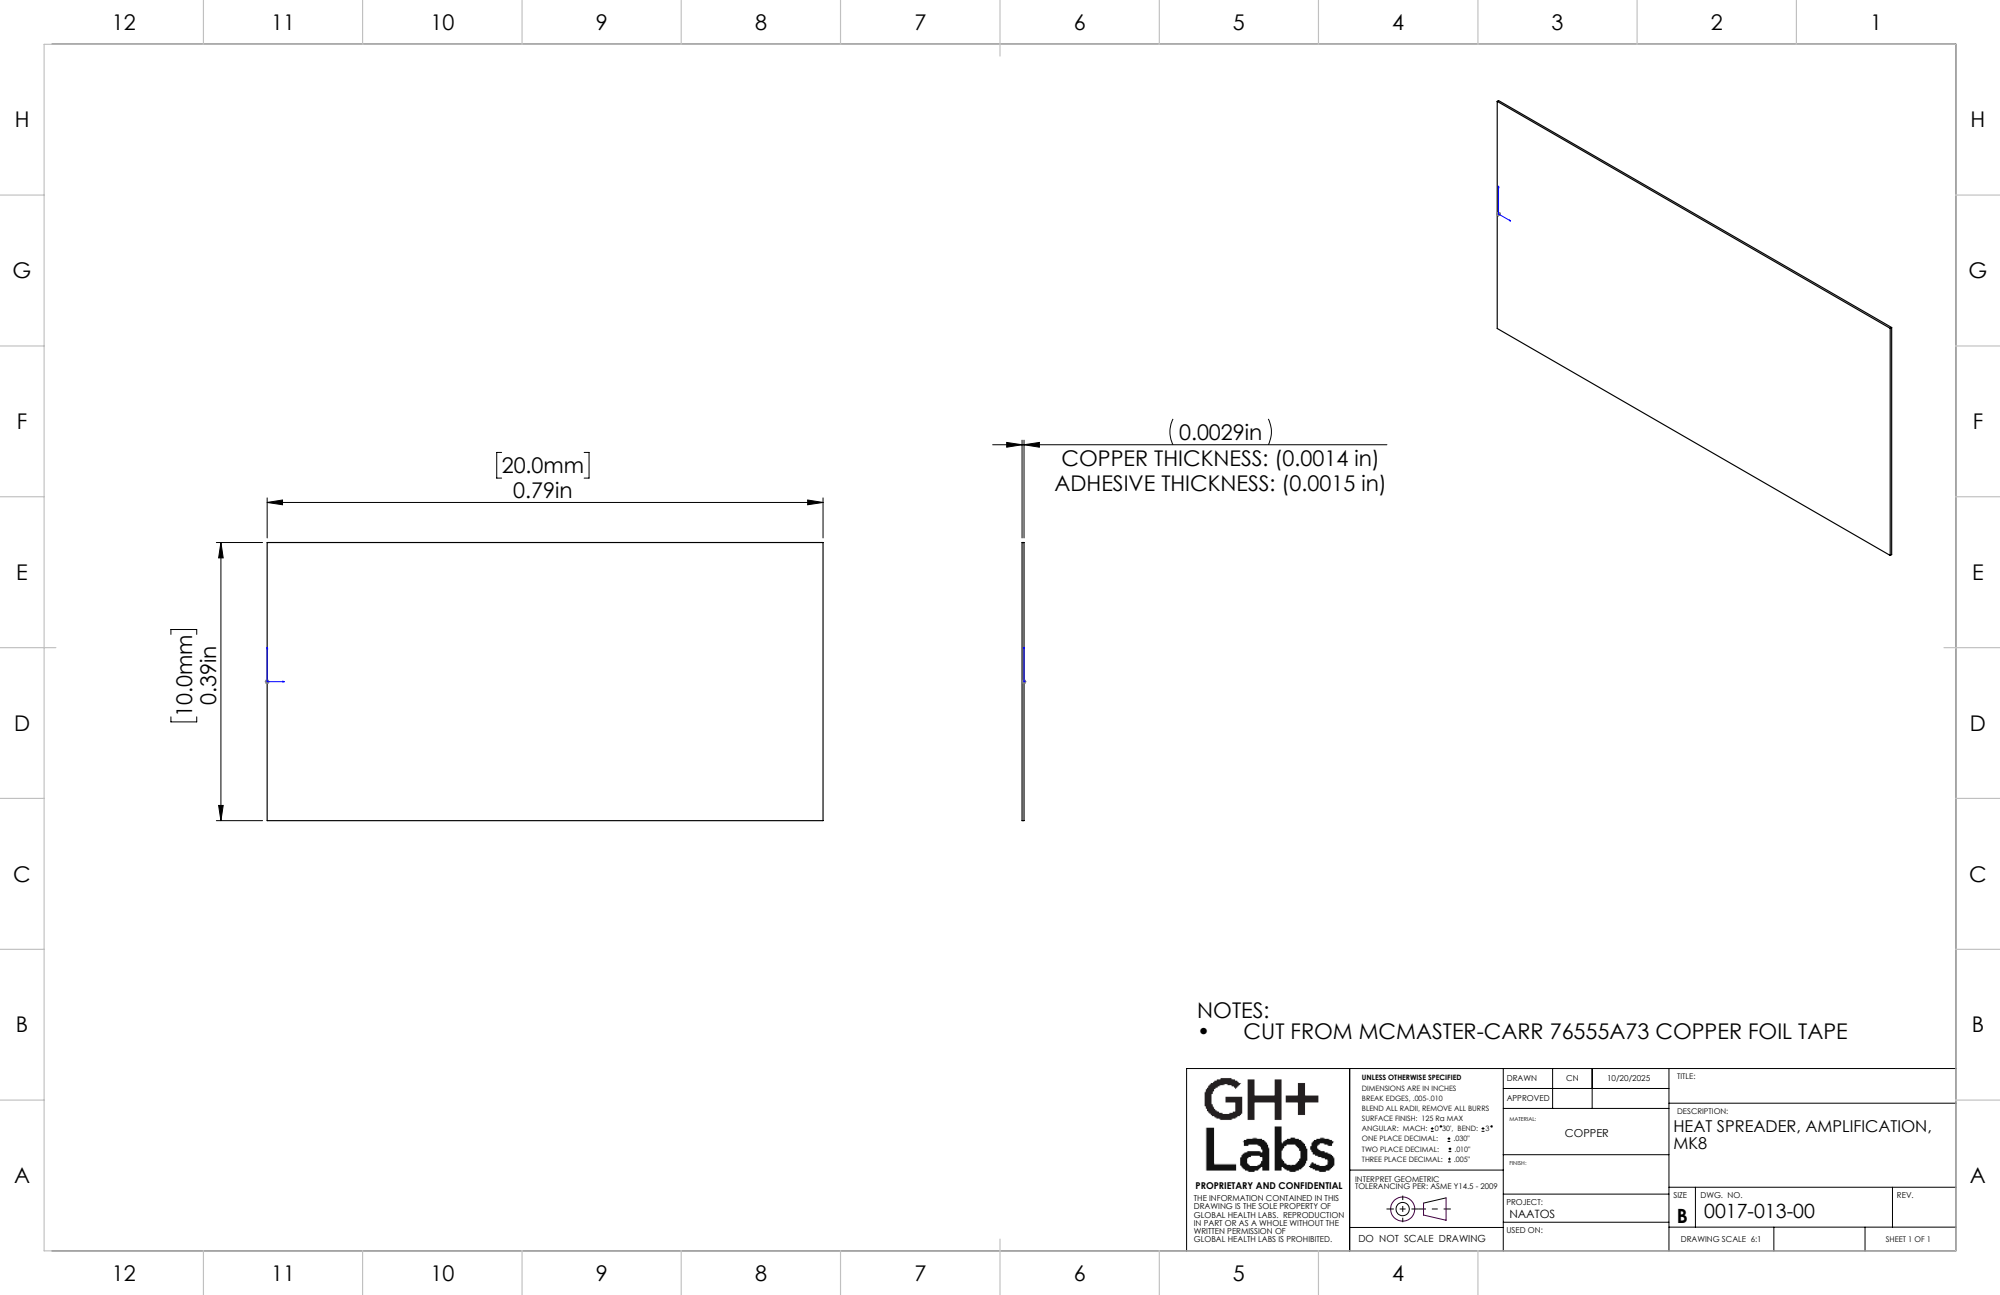
[picture p1: page 1]
SHEET 1 OF 1; DRAWING SCALE 6:1; DWG. NO.; UNLESS OTHERWISE SPECIFIED; ONE PLACE DECIMAL:; TWO PLACE DECIMAL:; HEAT SPREADER, AMPLIFICATION,; USED ON:

COPPER THICKNESS: (0.0014 in)
ADHESIVE THICKNESS: (0.0015 in)

NOTES:
• CUT FROM MCMASTER-CARR 76555A73 COPPER FOIL TAPE

DIMENSIONS ARE IN INCHES
BREAK EDGES, .005-.010
BLEND ALL RADII, REMOVE ALL BURRS
SURFACE FINISH: 125 Ra MAX
ANGULAR: MACH: 0 30', BEND: 3
THREE PLACE DECIMAL: .005"
INTERPRET GEOMETRIC
TOLERANCING PER: ASME Y14.5 - 2009

PROPRIETARY AND CONFIDENTIAL
THE INFORMATION CONTAINED IN THIS
DRAWING IS THE SOLE PROPERTY OF
GLOBAL HEALTH LABS. REPRODUCTION
IN PART OR AS A WHOLE WITHOUT THE
WRITTEN PERMISSION OF
GLOBAL HEALTH LABS IS PROHIBITED.

DO NOT SCALE DRAWING
